hirame-tech/RCJ2023/img/Arduino-Leonardo_pinout.png

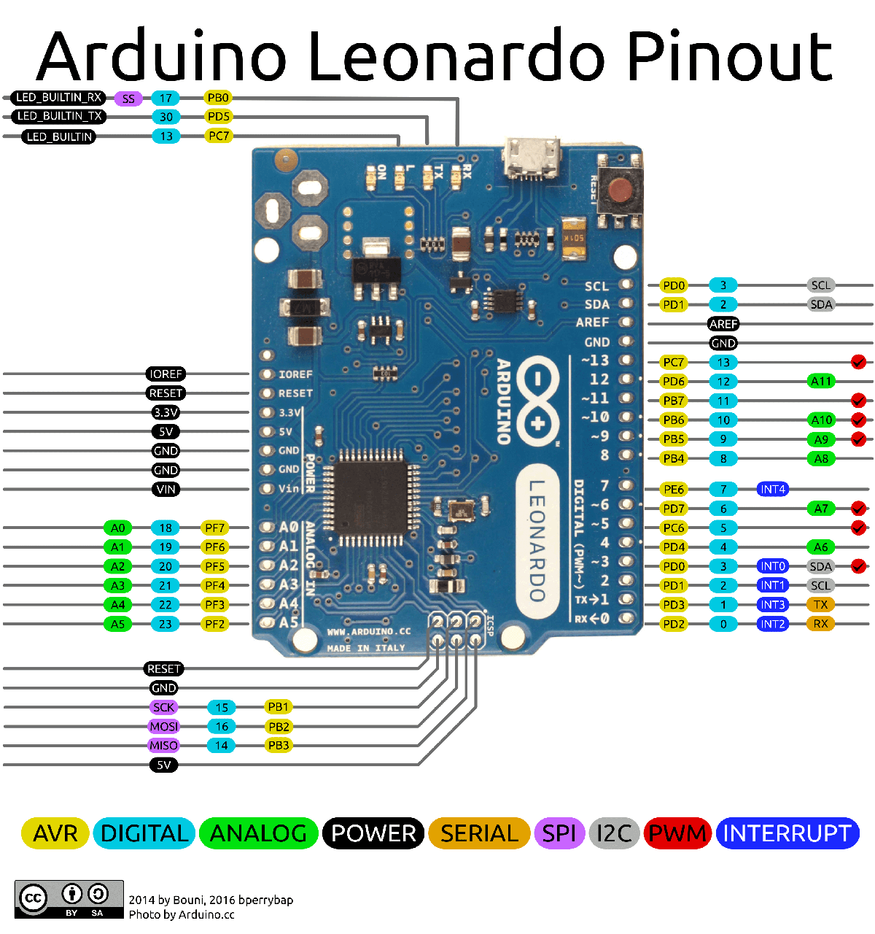
img/Arduino-Leonardo_pinout.png
