hirame-tech/RCJ2023/README.md

# README規則
- 基板のバージョンごとの変更点、issue等はboard内の各基板フォルダに書く
- その他仕様等はプログラムが保存されているフォルダ内の一番上の階層に配置されたREADMEに記述する。
