hirame-tech/RCJ2023/IRsensor/README.md

# pin assignment
|IR number|32U4 Pin|Digital Pin|
| :---: | :---: | :---: |
|0|19|2|
|1|25|4|
|2|26|12|
|3|27|6|
|4|28|8|
|5|29|9|
|6|1|7|
|7|41|23(A5)|
|8|40|22(A4)|
|9|39|21(A3)|
|10|38|20(A2)|
|11|37|19(A1)|
|12|36|18(A0)|
|13|32|13|
|14|31|5|
|15|30|10|
