hirame-tech/RCJ2023/main/README.md

Information of mainborad structure

## Teensy4.0
- Serial0 USB
- Serial1 IRsensor
- Serial2 Jyrosensor
- Serial3 Camera
- Serial4 motor0
- Serial5 motor1
- Serial6 motor2
- Serial7 motor3
