hirame-tech/RCJ2023/motor_driver_for_VNH/README.md

## 通信プロトコル
|data|解釈|
|----|----|
|0~100|motorA -255~255|
|128~228|motorB -255~255|
