hirame-tech/RCJ2023/board/power_supply/README.md

## power supply board v1
- OKLを手はんだに対応させた方がいいのでは？
- ヒューズの長さが違う
