hirame-tech/RCJ2023/motor_driver/README.md

# Serial通信内容
|data|解釈|
|----|----|
|0|ロック(未実装)|
|1~26|未定義|
|27~126|逆転 100 ~ 1|
|127|free stop|
|128~227|正転1~100|
|228~255|未定義|
