hirame-tech/RCJ2023/board/IRsensor/README.md

## v1_issure
- ~左のIRが上に1mmずれてる~ v1内で修正済み
- SPI引き出し忘れ
