hirame-tech/RCJ2023/board/mainboard/README.md

#v1 isuue
 - RCフィルタのコンデンサがin側についている(out側にないといけない)
