hirame-tech/RCJ2023/img/motor_direction.png

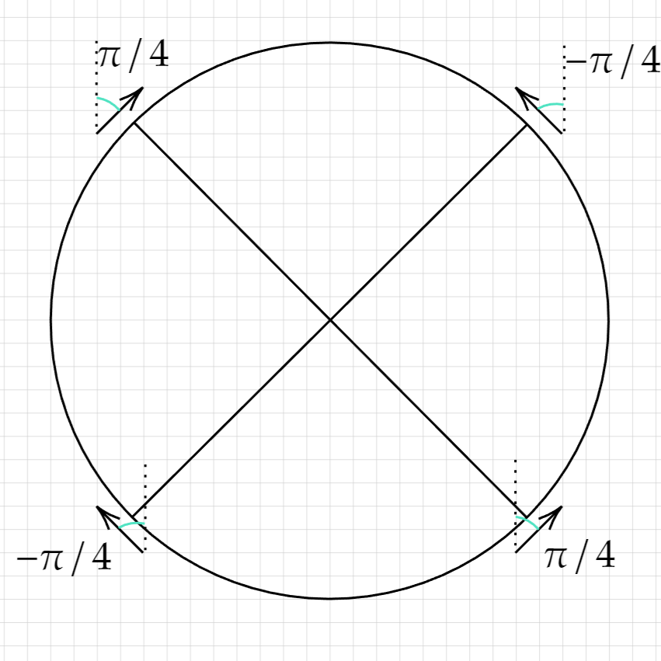
img/motor_direction.png
