hirame-tech/RCJ2023/board/BLDCdriver_test/encorder/parts_value.PNG

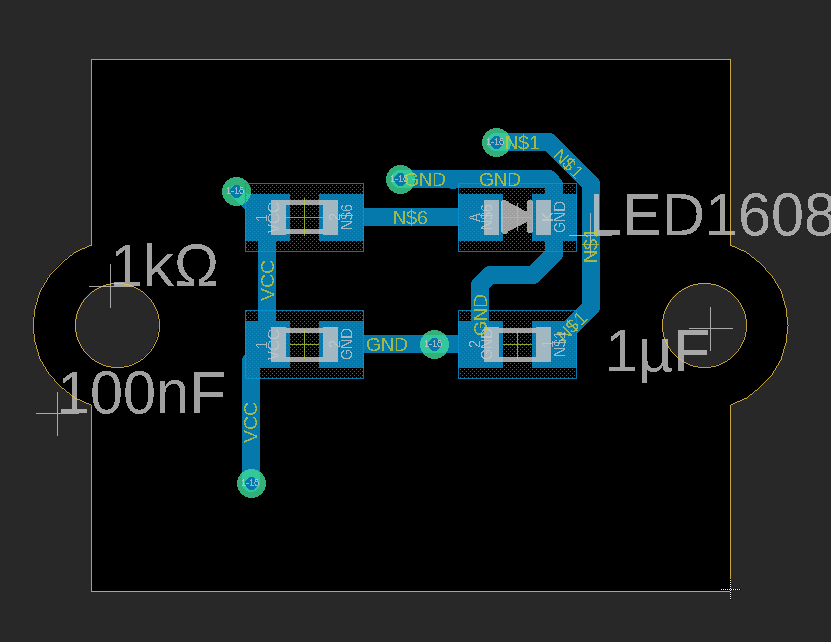
board/BLDCdriver_test/encorder/parts_value.PNG
