hirame-tech/RCJ2023/board/BLDCdriver_test/BLDCdriver v1.1/dimention_driver.dxf

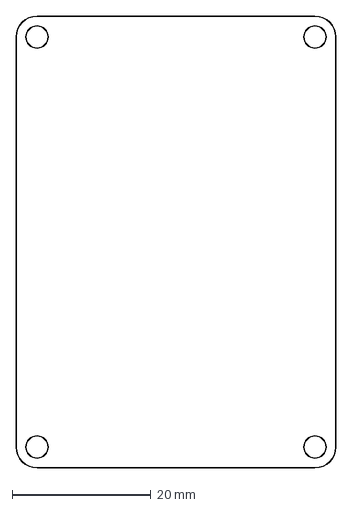
[picture p4: CAD file, 2022-12-12]
board/BLDCdriver_test/BLDCdriver v1.1/dimention_driver.dxf
46.0 x 65.0 mm
