hirame-tech/RCJ2023/board/BLDCdriver_test/encorder/Dimentions.dxf

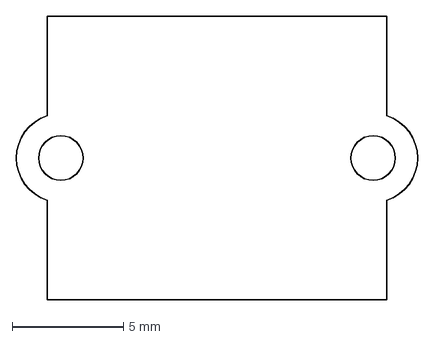
[picture p5: CAD file, 2022-12-12]
board/BLDCdriver_test/encorder/Dimentions.dxf
18.0 x 12.7 mm
