hirame-tech/RCJ2023/board/gyrosensor/dimention.dxf

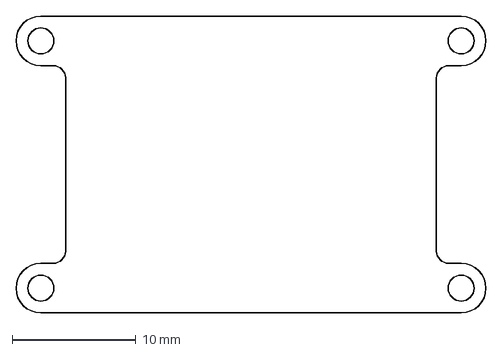
[picture p6: CAD file, 2022-12-12]
board/gyrosensor/dimention.dxf
38.0 x 24.0 mm
