hirame-tech/RCJ2023/board/IRsensor/dimension.dxf

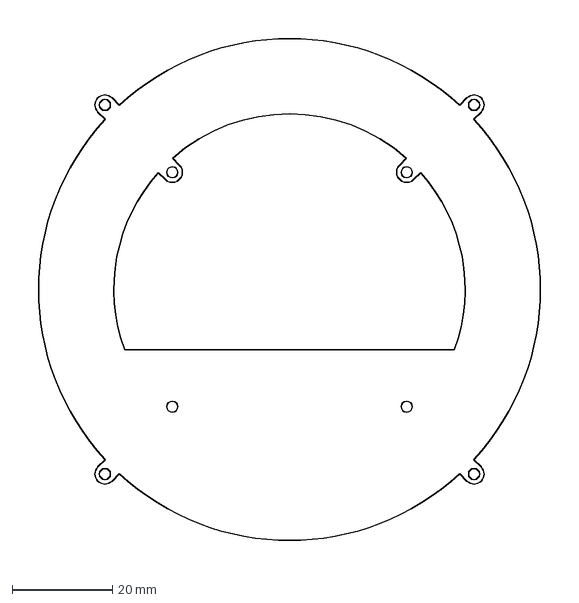
[picture p7: CAD file, 2022-12-12]
board/IRsensor/dimension.dxf
108.8 x 108.8 mm
