hirame-tech/RCJ2023/board/line_sensor_test/dimention.dxf

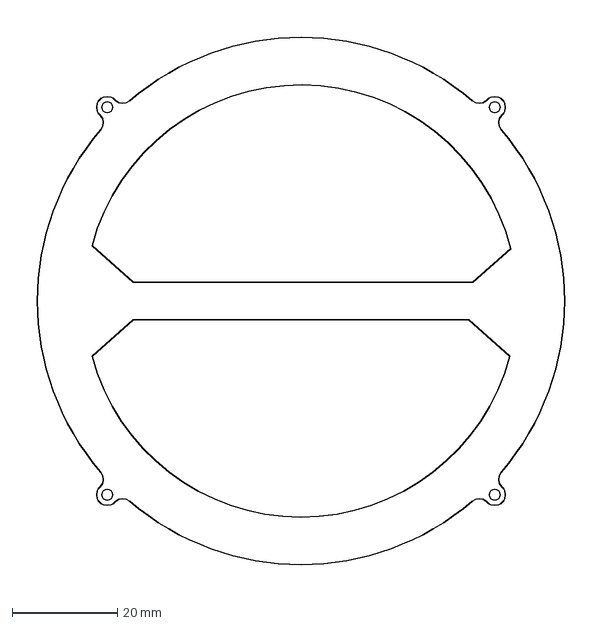
[picture p8: CAD file, 2022-12-12]
board/line_sensor_test/dimention.dxf
108.0 x 108.0 mm
