hirame-tech/RCJ2023/board/mainboard/dimention.dxf

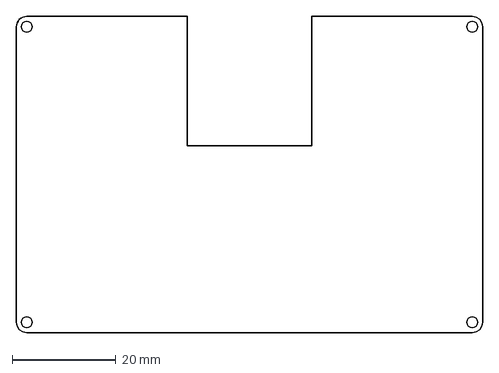
[picture p9: CAD file, 2022-12-12]
board/mainboard/dimention.dxf
90.0 x 61.0 mm
