hirame-tech/RCJ2023/board/power_supply/dimention.dxf

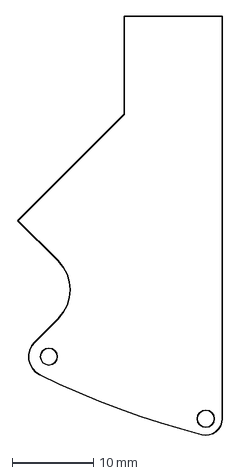
[picture p10: CAD file, 2022-12-12]
board/power_supply/dimention.dxf
25.1 x 51.5 mm
