hirame-tech/RCJ2023/board/power_supply/v2/diem.dxf

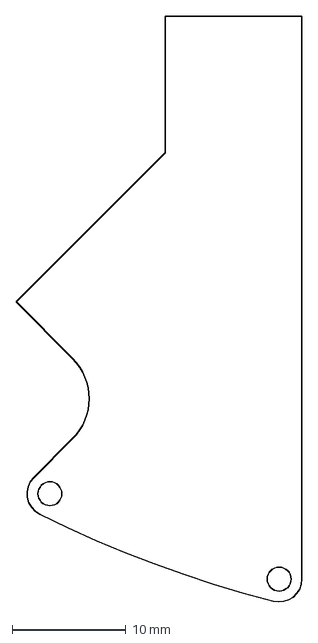
[picture p11: CAD file, 2022-12-12]
board/power_supply/v2/diem.dxf
25.1 x 51.5 mm
