hirame-tech/RCJ2023/board/UI_board/v1/dimention.dxf

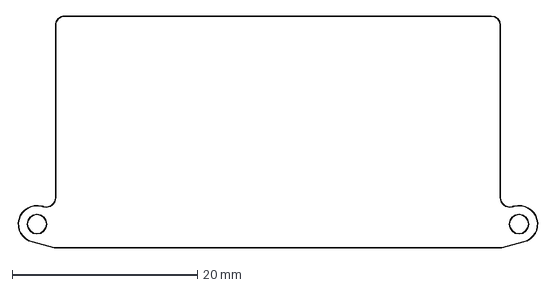
[picture p12: CAD file, 2022-12-12]
board/UI_board/v1/dimention.dxf
56.4 x 25.0 mm
