hirame-tech/RCJ2023/software_test/line_sensor/README.md

ラインセンサのArduinoUnoによる開発用のプロジェクトです。

2022-12-08現在、teensyに搭載したのでその状態から変更なし。今後の変更はmainの方で行う。
