hirame-tech/RCJ2023/board/BLDCdriver_test/README.md

## issue v1.0
- 1.SPIのSSの未配線
→~~CSをMD基板側でGNDに落として解決(v1.1)~~→SSをD6に配線
- 2.電源コネクタの配線が逆 → 元に戻した(v1.1)
