hirame-tech/RCJ2023/software_test/SerialReader/README.md

## SerialReaderの概要

30個のセンサ値をArduinoのシリアル出力から受け取り、256段階のグレースケールで表現します。
`rgb(0,0,0)`から`rgb(0,0,256)`

## 入力
0,1,2,3,4,5,6,...,30のようにカンマ区切りで30個のデータを読み込みます。

## 操作
`-select-`から任意のCOMを選択します。

なお、USBポートを抜き差ししたときには`Re-Scan`ボタンでCOMポートを再スキャンします。

`open`ボタンを押すとCOMのシリアルを開き、動作を開始します。

`close`ボタンでシリアルを閉じます。

`clear`ボタンで現在の読み込んだセンサ値を一度リセットします。

## バージョン情報

2022-11-19 ver0.0.1公開
- Splitコマンドでも分割ができなかった問題を修正。
- グレースケールでの表示に切り替え。
- GitHub上に初公開。
