hirame-tech/RCJ2023/board/BLDCdriver_test/BLDCdriver v1.0/untitled.brd

## EAGLE design board/BLDCdriver_test/BLDCdriver v1.0/untitled.brd (2022-12-12, an earlier design)

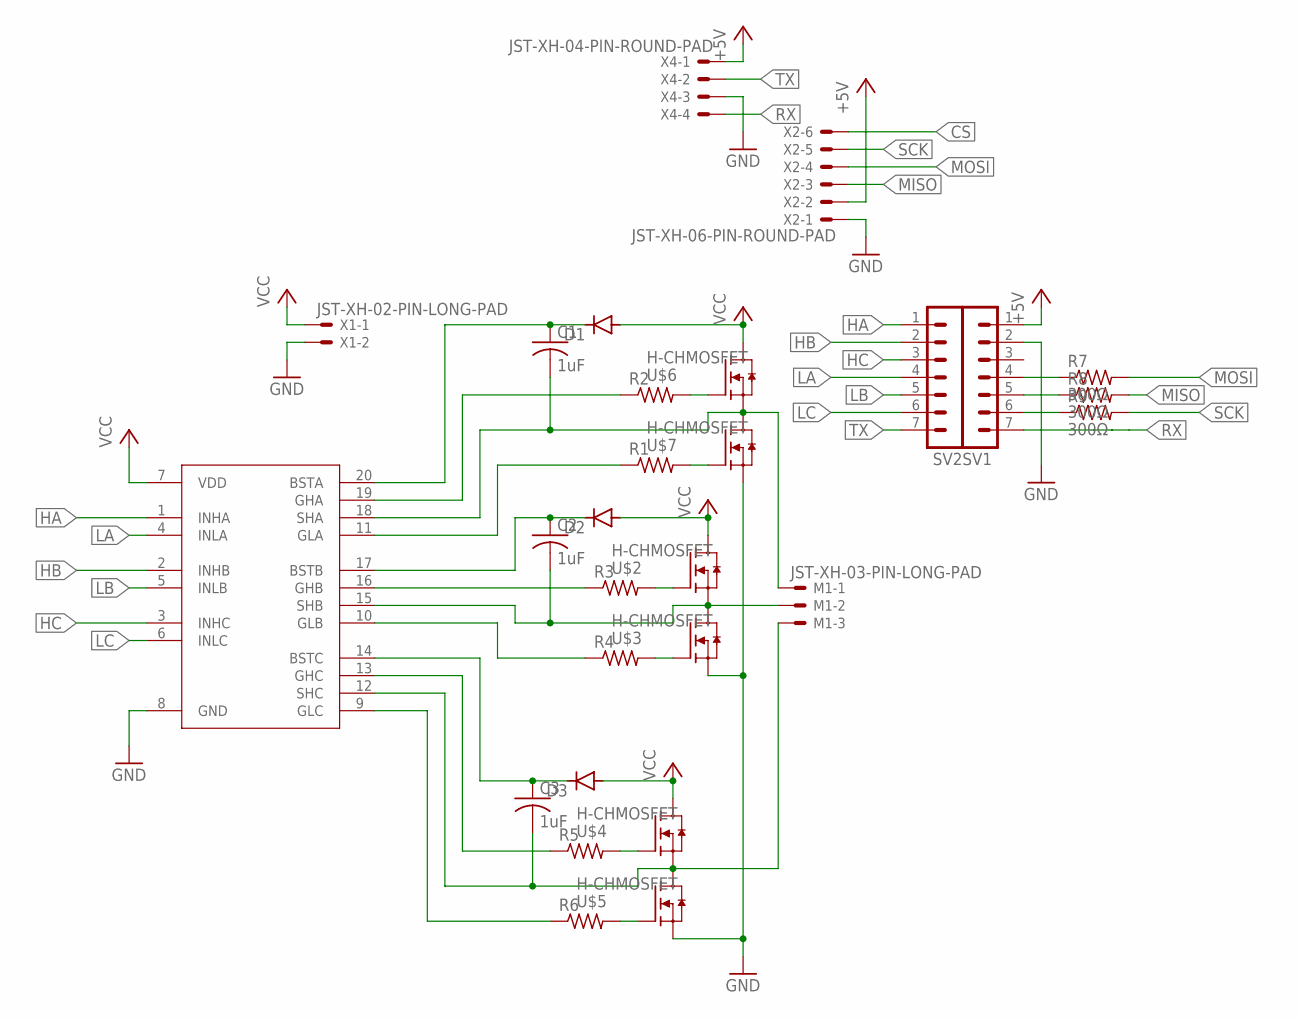
[picture p13: schematic untitled.sch]

Parts:
C1, C2, C3: 1uF; C2012
D1, D2, D3: DIODE-DO-214AC; DO-214AC
M1: JST-XH-03-PIN-LONG-PAD; JST-XH-03-PACKAGE-LONG-PAD
R1, R2, R3, R4, R5, R6: R-US_M2012; M2012
R7, R8, R9: 300Ω; M2012
SV1, SV2: MA07-1
U$1: DRV8300NIPWR; SOIC65P640X120-20N
U$2, U$3, U$4, U$5, U$6, U$7: H-CHMOSFET; DPAK228P990X238-4N
X1: JST-XH-02-PIN-LONG-PAD; JST-XH-02-PACKAGE-LONG-PAD
X2: JST-XH-06-PIN-ROUND-PAD; JST-XH-06-PACKAGE-ROUND-PAD
X4: JST-XH-04-PIN-ROUND-PAD; JST-XH-04-PACKAGE-ROUND-PAD

Connections:
+5V: SV1.1, X2.2, X4.1
CS: X2.6
GND: SV1.2, U$1.8 (GND), U$3.3 (S), U$5.3 (S), U$7.3 (S), X1.2, X2.1, X4.3
HA: SV2.1, U$1.1 (INHA)
HB: SV2.2, U$1.2 (INHB)
HC: SV2.3, U$1.3 (INHC)
LA: SV2.4, U$1.4 (INLA)
LB: SV2.5, U$1.5 (INLB)
LC: SV2.6, U$1.6 (INLC)
MISO: R8.2, X2.3
MOSI: R7.2, X2.4
unnamed: C2.2, M1.2, U$1.15 (SHB), U$2.3 (S), U$3.4 (D)
unnamed: C3.2, M1.3, U$1.12 (SHC), U$4.3 (S), U$5.4 (D)
unnamed: C1.2, M1.1, U$1.18 (SHA), U$6.3 (S), U$7.4 (D)
unnamed: R2.2, U$6.1 (G)
unnamed: R1.2, U$7.1 (G)
unnamed: R2.1, U$1.19 (GHA)
unnamed: R1.1, U$1.11 (GLA)
unnamed: R3.2, U$2.1 (G)
unnamed: C1.1, D1.C, U$1.20 (BSTA)
unnamed: R4.2, U$3.1 (G)
unnamed: R7.1, SV1.4
unnamed: R3.1, U$1.16 (GHB)
unnamed: C2.1, D2.C, U$1.17 (BSTB)
unnamed: R4.1, U$1.10 (GLB)
unnamed: R6.2, U$5.1 (G)
unnamed: R5.2, U$4.1 (G)
unnamed: R5.1, U$1.13 (GHC)
unnamed: R6.1, U$1.9 (GLC)
unnamed: C3.1, D3.C, U$1.14 (BSTC)
unnamed: R9.1, SV1.6
unnamed: R8.1, SV1.5
RX: SV1.7, X4.4
SCK: R9.2, X2.5
TX: SV2.7, X4.2
VCC: D1.A, D2.A, D3.A, U$1.7 (VDD), U$2.4 (D), U$4.4 (D), U$6.4 (D), X1.1

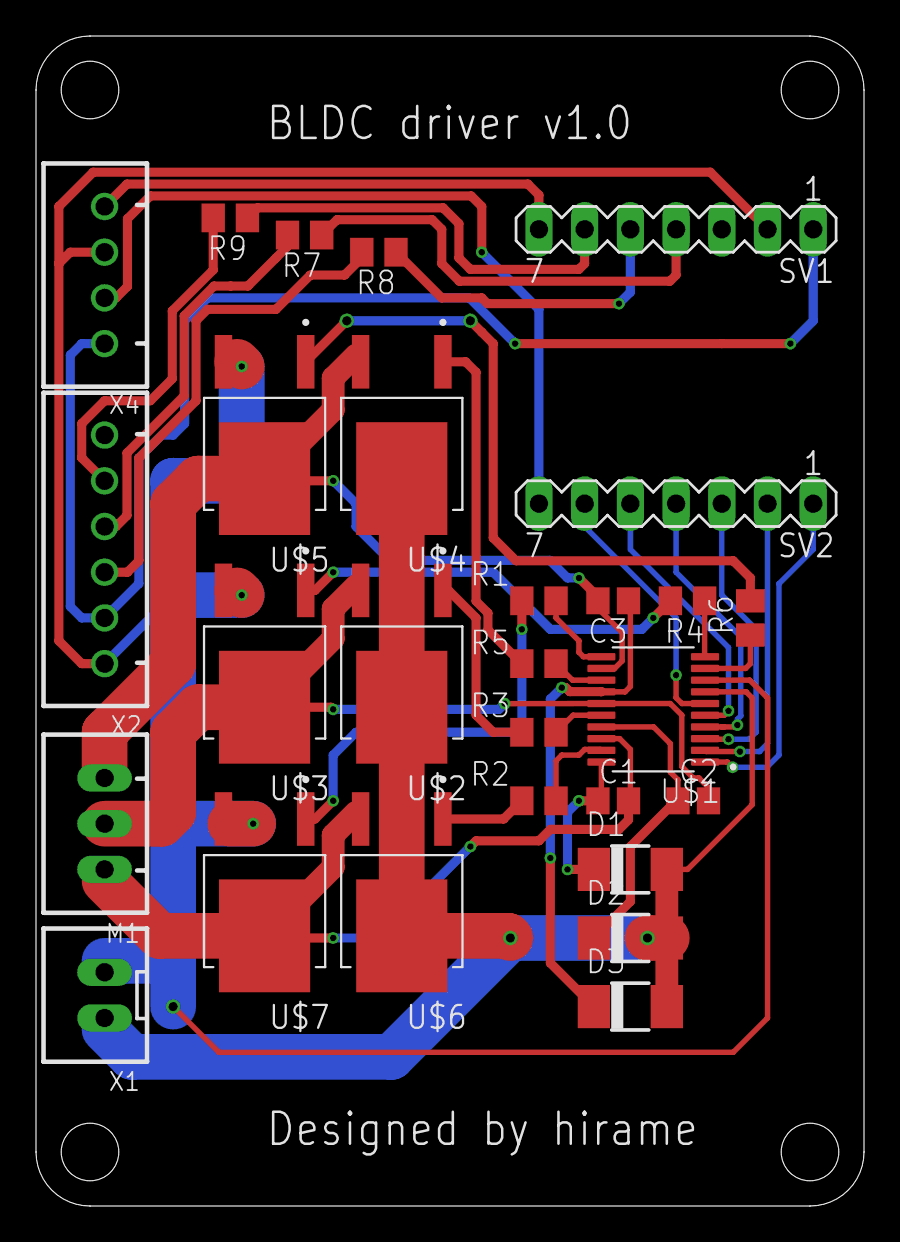
[picture p14: board board/BLDCdriver_test/BLDCdriver v1.0/untitled.brd from above]

Board: 2 copper layers, 46.0 x 65.0 mm, 28 parts (0 on the bottom side), 35 nets.
