hirame-tech/RCJ2023/board/usb_hub_board/untitled.brd

## EAGLE design board/usb_hub_board/untitled.brd (2022-12-12)

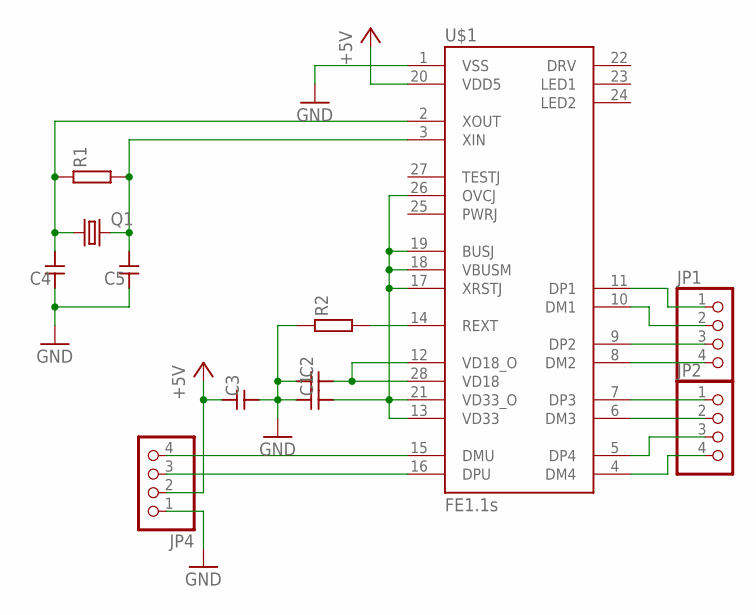
[picture p15: schematic untitled.sch]

Parts:
C1, C2, C3, C4, C5: CAPACITOR1608; SMD1608
JP1, JP2, JP4: PINHD-1X4; 1X04
Q1: CRYSTALHC49S; HC49/S
R1, R2: RESISTOR1608; SMD1608
U$1: FE1.1S; FE1.1S_SSOP-28

Connections:
+5V: C3.1, JP4.2, U$1.20 (VDD5)
GND: C1.1, C2.1, C3.2, C4.1, C5.1, JP4.1, R2.1, U$1.1 (VSS)
unnamed: JP4.4, U$1.15 (DMU)
unnamed: R2.2, U$1.14 (REXT)
unnamed: C2.2, U$1.12 (VD18_O), U$1.28 (VD18)
unnamed: C4.2, Q1.1, R1.1, U$1.2 (XOUT)
unnamed: C1.2, U$1.13 (VD33), U$1.17 (XRSTJ), U$1.18 (VBUSM), U$1.19 (BUSJ), U$1.21 (VD33_O), U$1.26 (OVCJ)
unnamed: C5.2, Q1.2, R1.2, U$1.3 (XIN)
unnamed: JP4.3, U$1.16 (DPU)
unnamed: JP1.4, U$1.8 (DM2)
unnamed: JP2.1, U$1.7 (DP3)
unnamed: JP2.2, U$1.6 (DM3)
unnamed: JP2.3, U$1.5 (DP4)
unnamed: JP2.4, U$1.4 (DM4)
unnamed: JP1.3, U$1.9 (DP2)
unnamed: JP1.2, U$1.10 (DM1)
unnamed: JP1.1, U$1.11 (DP1)

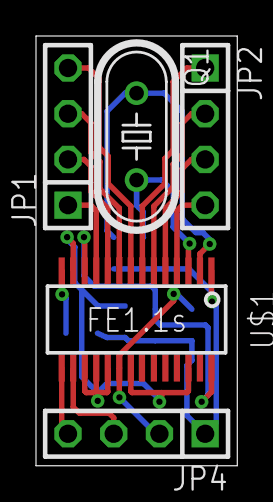
[picture p16: board board/usb_hub_board/untitled.brd from above]

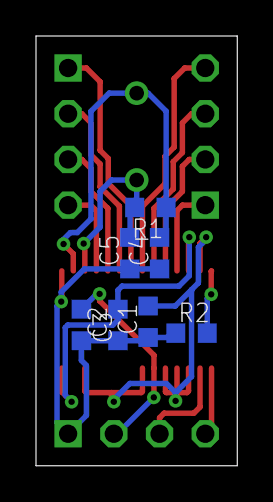
[picture p17: board board/usb_hub_board/untitled.brd from below]

Board: 2 copper layers, 11.2 x 23.9 mm, 12 parts (7 on the bottom side), 17 nets.
