hirame-tech/RCJ2023/board/catch_sensor/untitled.brd

## EAGLE design board/catch_sensor/untitled.brd (2022-12-12)

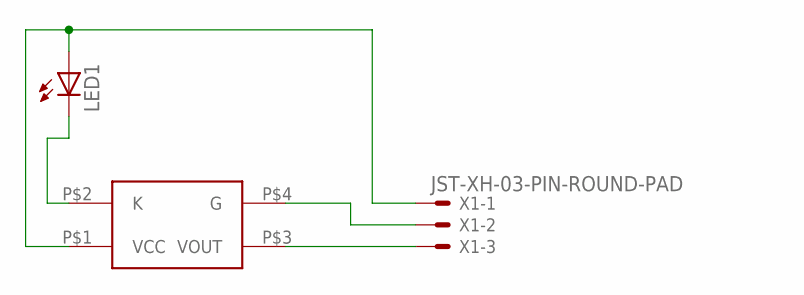
[picture p18: schematic untitled.sch]

Parts:
LED1: LED3MM
U$1: S4282-51
X1: JST-XH-03-PIN-ROUND-PAD; JST-XH-03-PACKAGE-ROUND-PAD

Connections:
unnamed: LED1.K (C), U$1.P$2 (K)
unnamed: U$1.P$3 (VOUT), X1.3
unnamed: LED1.A, U$1.P$1 (VCC), X1.1
unnamed: U$1.P$4 (G), X1.2

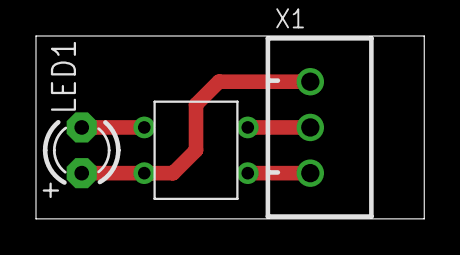
[picture p19: board board/catch_sensor/untitled.brd from above]

Board: 2 copper layers, 21.6 x 10.2 mm, 3 parts (0 on the bottom side), 4 nets.
