hirame-tech/RCJ2023/board/gyrosensor/untitled.brd

## EAGLE design board/gyrosensor/untitled.brd (2022-12-12)

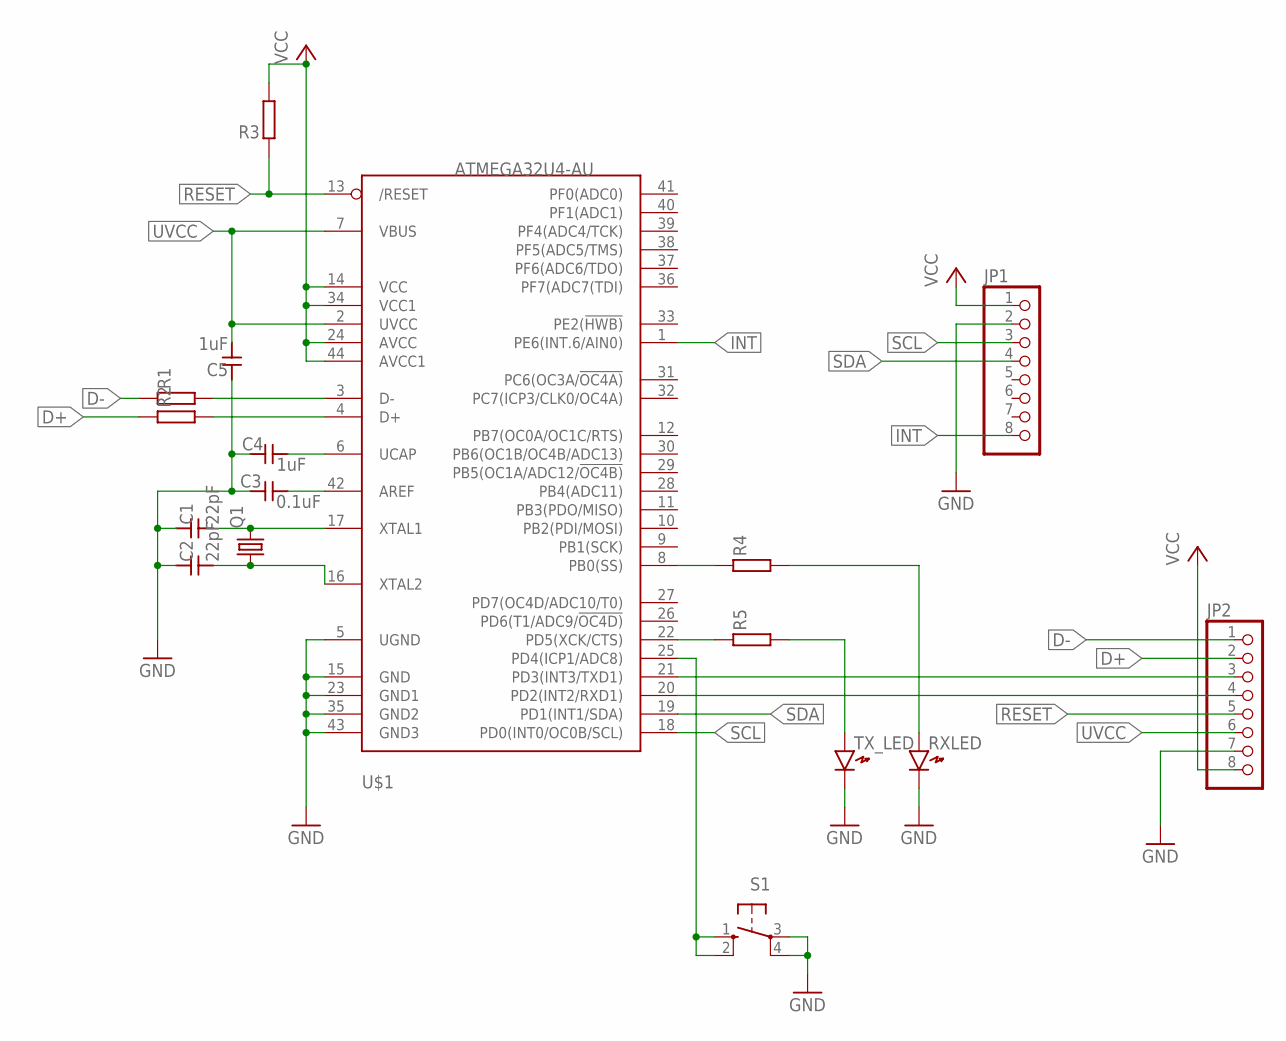
[picture p20: schematic untitled.sch]

Parts:
C1, C2: 22pF; SMD1608
C3: 0.1uF; SMD1608
C4, C5: 1uF; SMD1608
JP1, JP2: PINHD-1X8; 1X08
Q1: CRYSTALHC49S; HC49/S
R1, R2, R3, R4, R5: RESISTOR1608; SMD1608
RXLED: LED1608
S1: 10-XX; B3F-10XX
TX_LED: LED1608
U$1: ATMEGA32U4-AU; TQFP44

Connections:
D+: JP2.2, R2.1
D-: JP2.1, R1.1
GND: C1.1, C2.1, C3.1, C4.1, C5.1, JP1.2, JP2.7, RXLED.K, S1.3, S1.4 (P1), TX_LED.K, U$1.5 (UGND), U$1.15 (GND), U$1.23 (GND1), U$1.35 (GND2), U$1.43 (GND3)
INT: JP1.8, U$1.1 (PE6(INT.6/AIN0))
unnamed: C1.2, Q1.2, U$1.17 (XTAL1)
unnamed: C2.2, Q1.1, U$1.16 (XTAL2)
unnamed: C4.2, U$1.6 (UCAP)
unnamed: C3.2, U$1.42 (AREF)
unnamed: S1.1 (S), S1.2 (S1), U$1.25 (PD4(ICP1/ADC8))
unnamed: R4.1, U$1.8 (PB0(SS))
unnamed: R5.1, U$1.22 (PD5(XCK/CTS))
unnamed: R1.2, U$1.3 (D-)
unnamed: R2.2, U$1.4 (D+)
unnamed: R5.2, TX_LED.A
unnamed: R4.2, RXLED.A
unnamed: JP2.3, U$1.21 (PD3(INT3/TXD1))
unnamed: JP2.4, U$1.20 (PD2(INT2/RXD1))
RESET: JP2.5, R3.1, U$1.13 (/RESET)
SCL: JP1.3, U$1.18 (PD0(INT0/OC0B/SCL))
SDA: JP1.4, U$1.19 (PD1(INT1/SDA))
UVCC: C5.2, JP2.6, U$1.2 (UVCC), U$1.7 (VBUS)
VCC: JP1.1, JP2.8, R3.2, U$1.14 (VCC), U$1.24 (AVCC), U$1.34 (VCC1), U$1.44 (AVCC1)

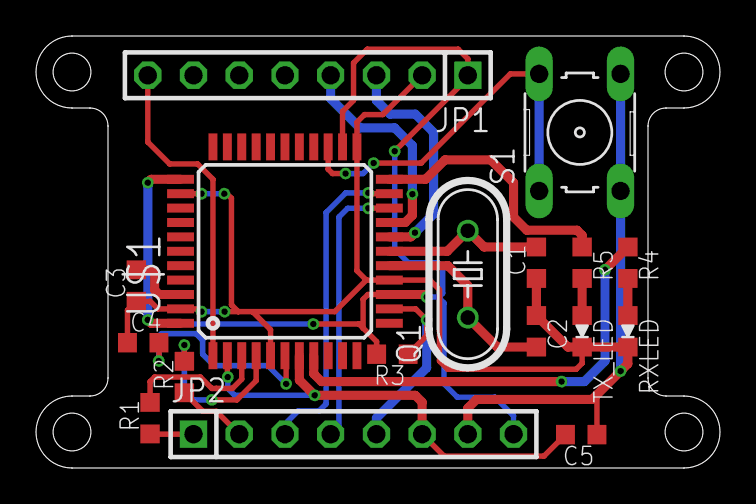
[picture p21: board board/gyrosensor/untitled.brd from above]

Board: 2 copper layers, 38.0 x 24.0 mm, 17 parts (0 on the bottom side), 22 nets.
