hirame-tech/RCJ2023/board/power_supply/v2/5v_unit.brd

## EAGLE design board/power_supply/v2/5v_unit.brd (2022-12-12)

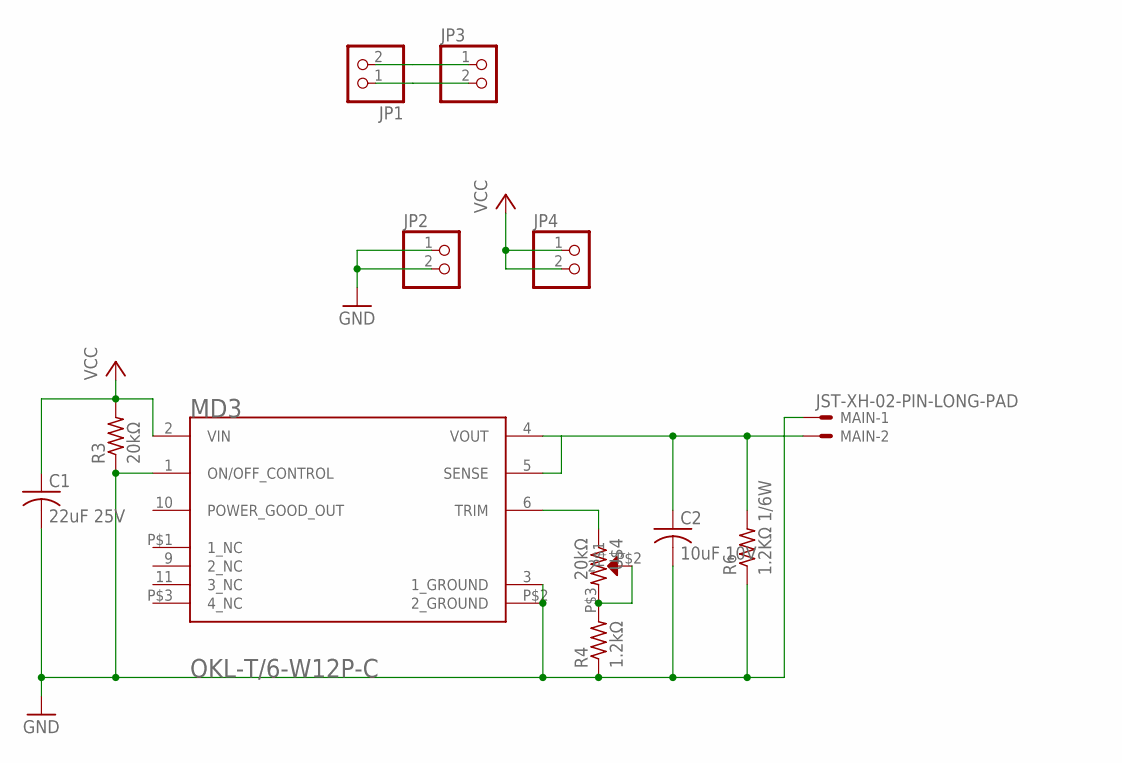
[picture p22: schematic 5v_unit.sch]

Parts:
C1: 22uF 25V; C2012
C2: 10uF 10V; C2012
JP1, JP2, JP3, JP4: PINHD-1X2; 1X02
MAIN: JST-XH-02-PIN-LONG-PAD; JST-XH-02-PACKAGE-LONG-PAD
MD3: OKL-T/6-W12P-CMURATA_OKL-T-6-W12P-C_0_0; MURATA_OKL-T-6-W12P-C_0
R3: 20kΩ; M2012
R4: 1.2kΩ; M2012
R6: 1.2KΩ 1/6W; 0805-THM
U$4: 20kΩ; R-TRIM

Connections:
GND: C1.2, C2.2, JP2.1, JP2.2, MAIN.1, MD3.1 (ON/OFF_CONTROL), MD3.3 (1_GROUND), MD3.P$2 (2_GROUND), R3.1, R4.1, R6.1
unnamed: JP1.1, JP1.2, JP3.1, JP3.2
unnamed: R4.2, U$4.P$2 (2), U$4.P$3
unnamed: C2.1, MAIN.2, MD3.4 (VOUT), MD3.5 (SENSE), R6.2
unnamed: MD3.6 (TRIM), U$4.P$1 (1)
VCC: C1.1, JP4.1, JP4.2, MD3.2 (VIN), R3.2

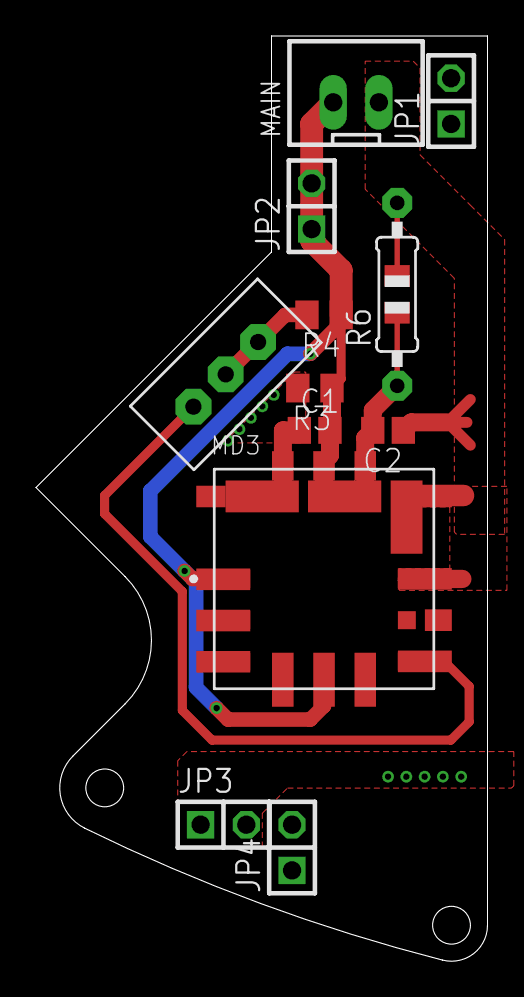
[picture p23: board 5v_unit.brd from above]

Board: 2 copper layers, 25.1 x 51.4 mm, 12 parts (0 on the bottom side), 6 nets.
