hirame-tech/RCJ2023/board/UI_board/v1/untitled.brd

## EAGLE design board/UI_board/v1/untitled.brd (2022-12-12)

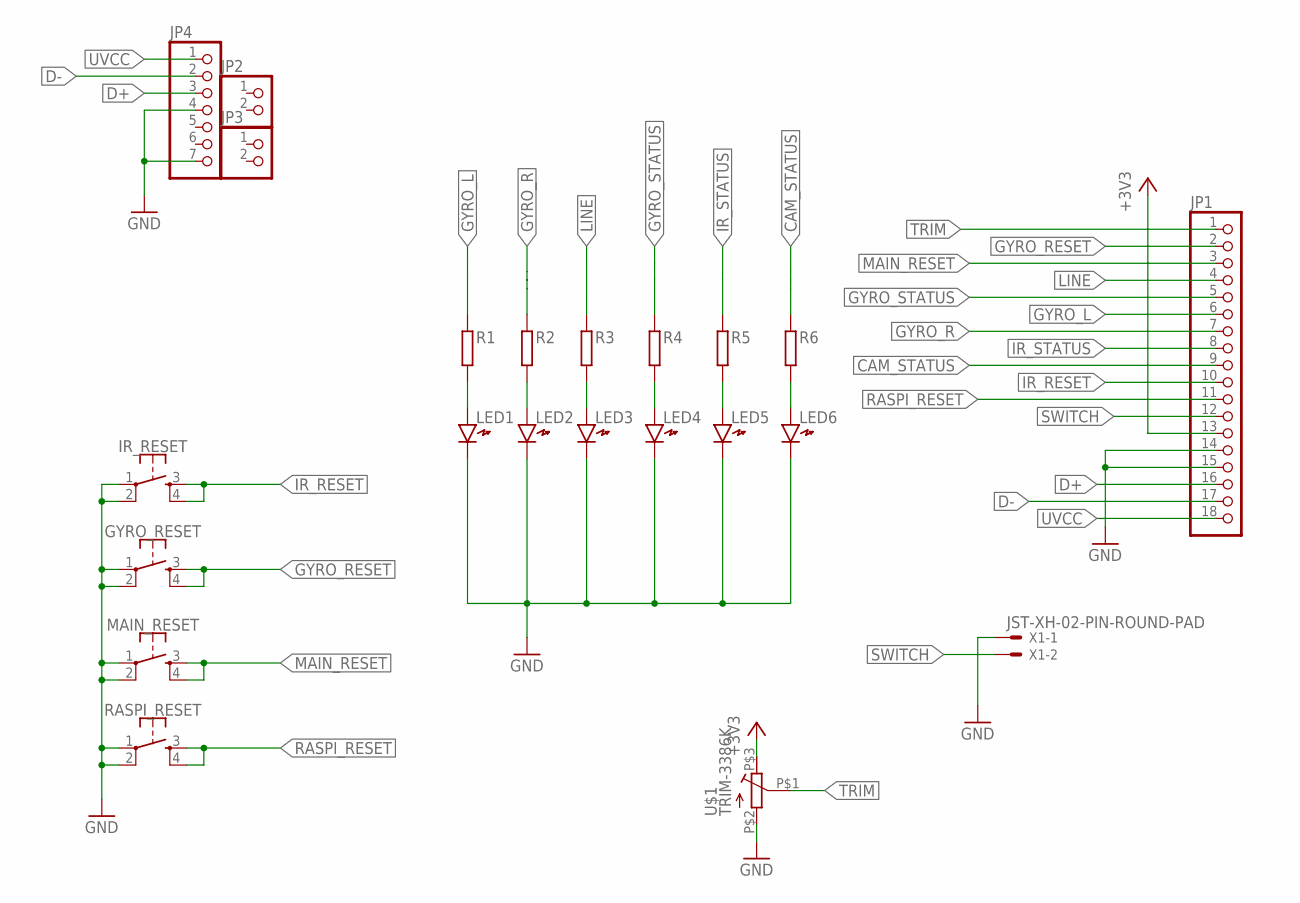
[picture p24: schematic untitled.sch]

Parts:
GYRO_RESET: MOMENTARY-SWITCH-SPST-2-SMD-5.2MM; TACTILE_SWITCH_SMD_5.2MM
IR_RESET: MOMENTARY-SWITCH-SPST-2-SMD-5.2MM; TACTILE_SWITCH_SMD_5.2MM
JP1: PINHD-1X18; 1X18
JP2, JP3: PINHD-1X2; 1X02
JP4: PINHD-1X7; 1X07
LED1, LED2, LED3, LED4, LED5, LED6: LED1608
MAIN_RESET: MOMENTARY-SWITCH-SPST-2-SMD-5.2MM; TACTILE_SWITCH_SMD_5.2MM
R1, R2, R3, R4, R5, R6: RESISTOR1608; SMD1608
RASPI_RESET: MOMENTARY-SWITCH-SPST-2-SMD-5.2MM; TACTILE_SWITCH_SMD_5.2MM
U$1: TRIM-3386K
X1: JST-XH-02-PIN-ROUND-PAD; JST-XH-02-PACKAGE-ROUND-PAD

Connections:
+3V3: JP1.13, U$1.P$3 (1)
CAM_STATUS: JP1.9, R6.1
D+: JP1.16, JP4.3
D-: JP1.17, JP4.2
GND: GYRO_RESET.1, GYRO_RESET.2, IR_RESET.1, IR_RESET.2, JP1.14, JP1.15, JP4.4, JP4.7, LED1.K, LED2.K, LED3.K, LED4.K, LED5.K, LED6.K, MAIN_RESET.1, MAIN_RESET.2, RASPI_RESET.1, RASPI_RESET.2, U$1.P$2 (2), X1.1
GYRO_L: JP1.6, R1.1
GYRO_R: JP1.7, R2.1
GYRO_RESET: GYRO_RESET.3, GYRO_RESET.4, JP1.2
GYRO_STATUS: JP1.5, R4.1
IR_RESET: IR_RESET.3, IR_RESET.4, JP1.10
IR_STATUS: JP1.8, R5.1
LINE: JP1.4, R3.1
MAIN_RESET: JP1.3, MAIN_RESET.3, MAIN_RESET.4
unnamed: LED1.A, R1.2
unnamed: LED2.A, R2.2
unnamed: LED3.A, R3.2
unnamed: LED4.A, R4.2
unnamed: LED5.A, R5.2
unnamed: LED6.A, R6.2
RASPI_RESET: JP1.11, RASPI_RESET.3, RASPI_RESET.4
SWITCH: JP1.12, X1.2
TRIM: JP1.1, U$1.P$1 (3)
UVCC: JP1.18, JP4.1

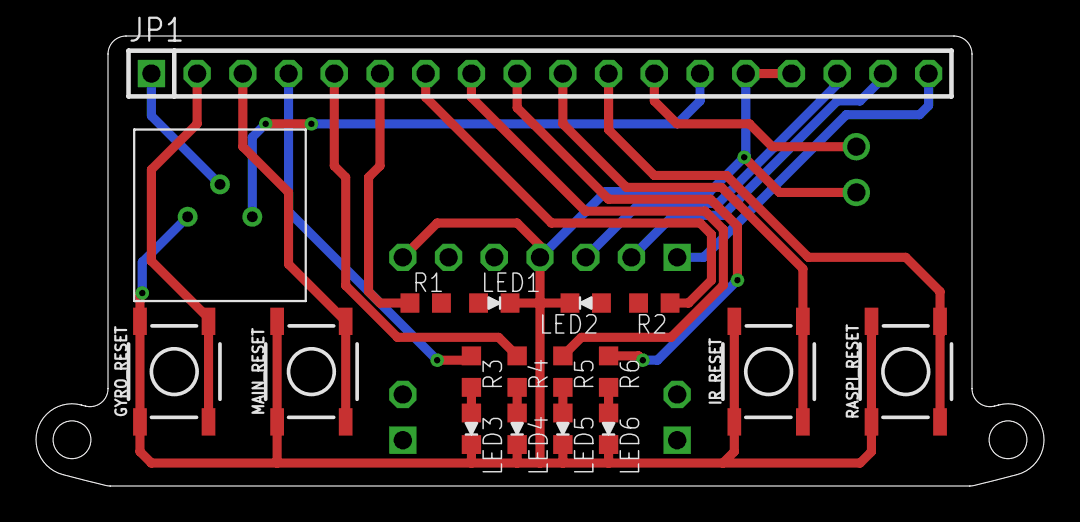
[picture p25: board board/UI_board/v1/untitled.brd from above]

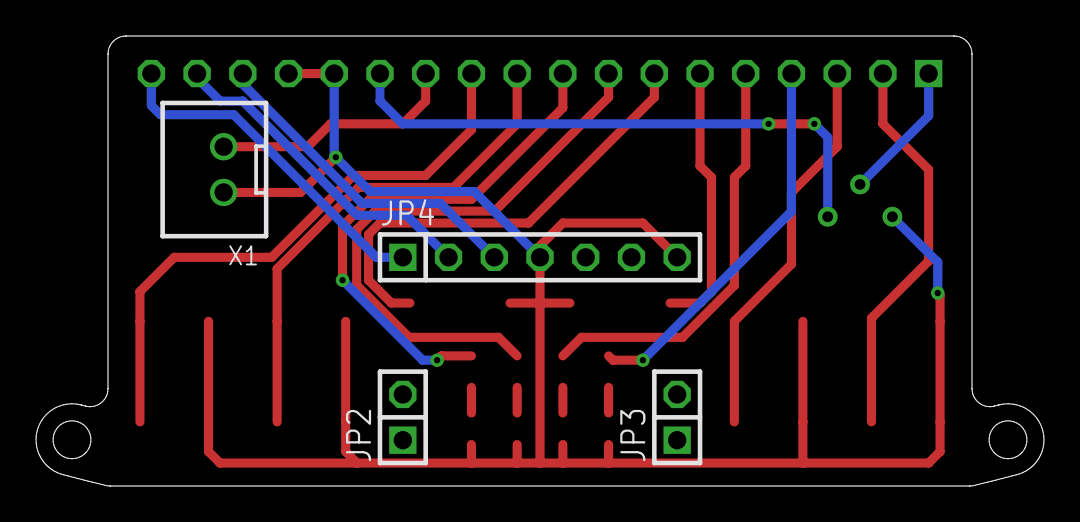
[picture p26: board board/UI_board/v1/untitled.brd from below]

Board: 2 copper layers, 56.0 x 25.0 mm, 22 parts (4 on the bottom side), 23 nets.
