hirame-tech/RCJ2023/board/mainboard/untitled.brd

## EAGLE design board/mainboard/untitled.brd (2022-12-12)

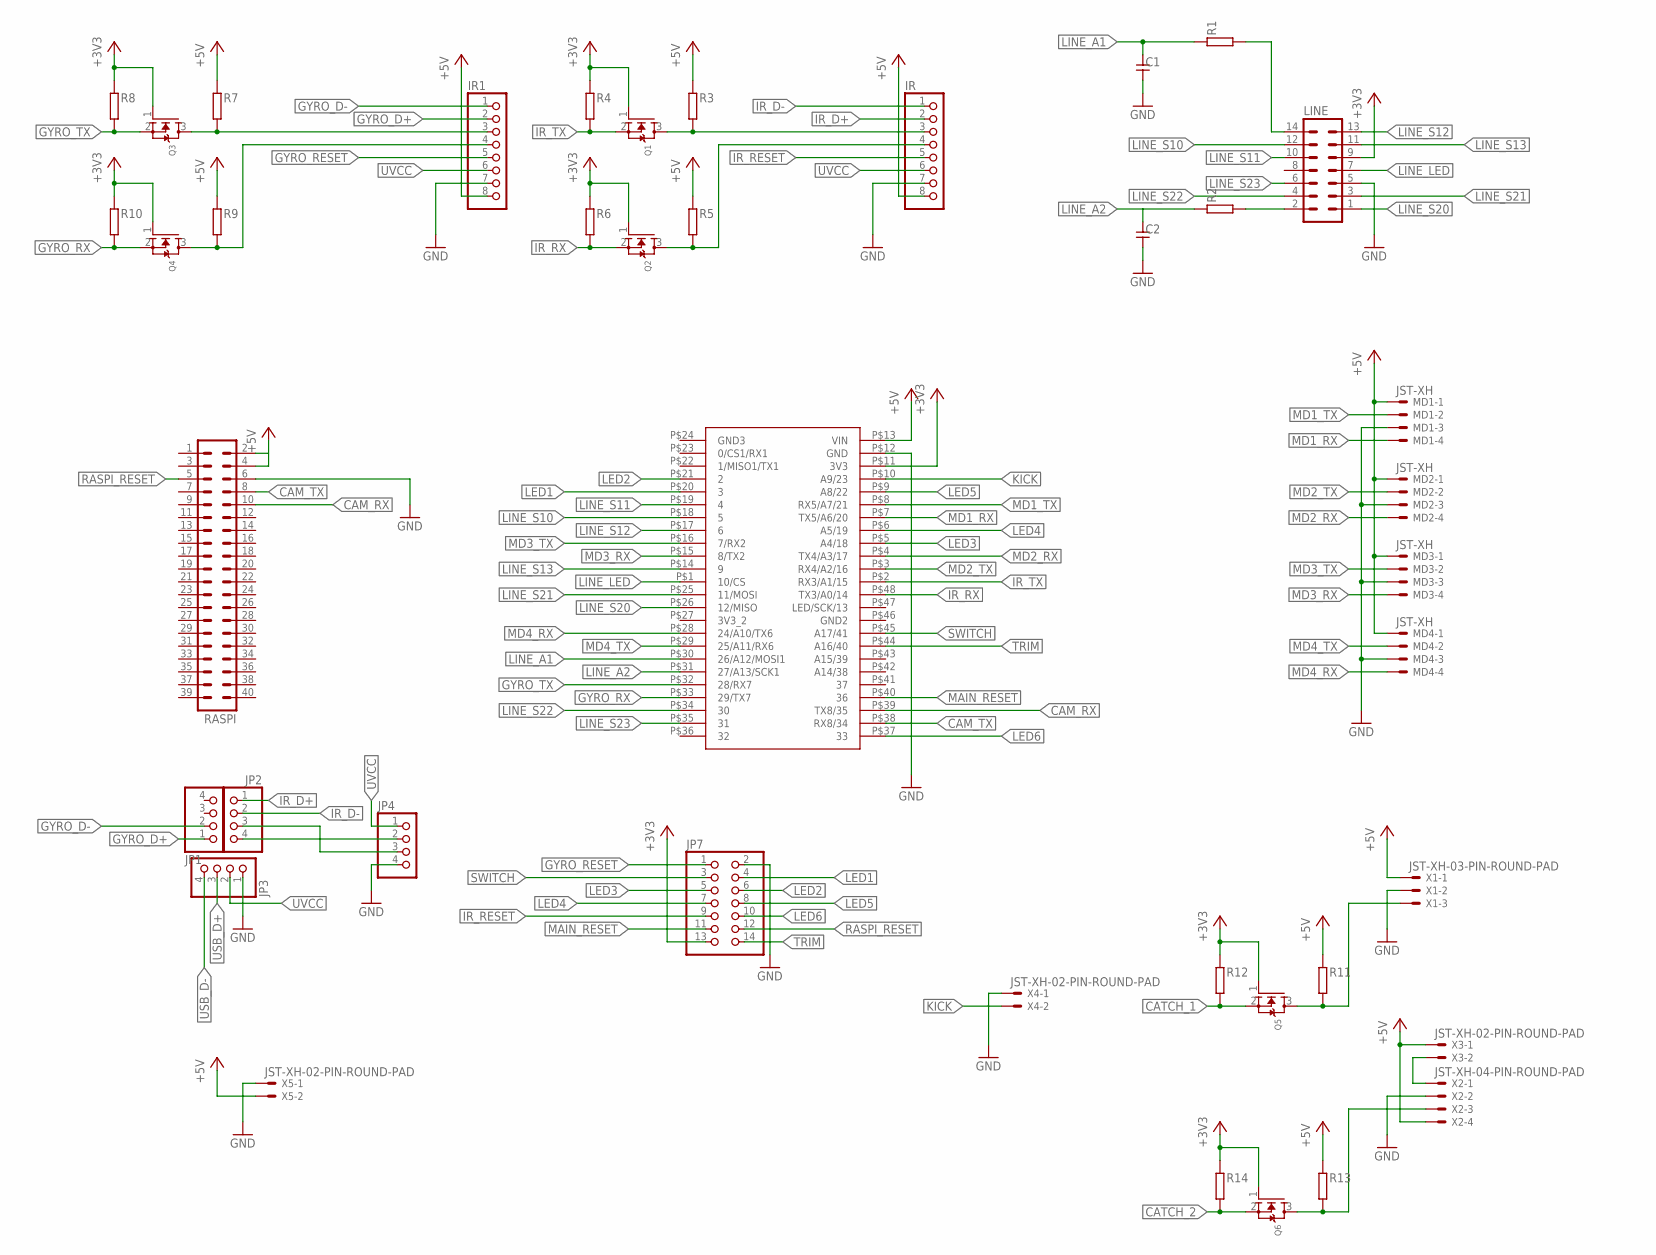
[picture p27: schematic untitled.sch]

Parts:
C1, C2: CAPACITOR1608; SMD1608
IR, IR1: PINHD-1X8; 1X08
JP1, JP2, JP3, JP4: PINHD-1X4; 1X04
JP7: PINHD-2X7; 2X07
LINE: MA07-2
MD1, MD2, MD3, MD4: JST-XH; JST-XH-04-PACKAGE-ROUND-PAD
Q1, Q2, Q3, Q4, Q5, Q6: MOSFET-NREFLOW; SOT23
R1, R2, R3, R4, R5, R6, R7, R8, R9, R10, R11, R12, R13, R14: RESISTOR1608; SMD1608
RASPI: MA20-2
U$1: TEENSY4.1
X1: JST-XH-03-PIN-ROUND-PAD; JST-XH-03-PACKAGE-ROUND-PAD
X2: JST-XH-04-PIN-ROUND-PAD; JST-XH-04-PACKAGE-ROUND-PAD
X3, X4, X5: JST-XH-02-PIN-ROUND-PAD; JST-XH-02-PACKAGE-ROUND-PAD

Connections:
+3V3: JP7.13, LINE.9, Q1.1 (G), Q2.1 (G), Q3.1 (G), Q4.1 (G), Q5.1 (G), Q6.1 (G), R4.1, R6.1, R8.1, R10.1, R12.1, R14.1, U$1.P$11 (3V3)
+5V: IR.8, IR1.8, MD1.1, MD2.1, MD3.1, MD4.1, R3.1, R5.1, R7.1, R9.1, R11.1, R13.1, RASPI.2, RASPI.4, U$1.P$13 (VIN), X1.1, X2.4, X3.1, X5.2
CAM_RX: RASPI.10, U$1.P$39 (TX8/35)
CAM_TX: RASPI.8, U$1.P$38 (RX8/34)
CATCH_1: Q5.2 (S), R12.2
CATCH_2: Q6.2 (S), R14.2
GND: C1.2, C2.2, IR.7, IR1.7, JP3.1, JP4.4, JP7.2, LINE.5, MD1.3, MD2.3, MD3.3, MD4.3, RASPI.6, U$1.P$12 (GND), X1.2, X2.2, X4.1, X5.1
GYRO_D+: IR1.2, JP1.1
GYRO_D-: IR1.1, JP1.2
GYRO_RESET: IR1.5, JP7.1
GYRO_RX: Q4.2 (S), R10.2, U$1.P$33 (29/TX7)
GYRO_TX: Q3.2 (S), R8.2, U$1.P$32 (28/RX7)
IR_D+: IR.2, JP2.1
IR_D-: IR.1, JP2.2
IR_RESET: IR.5, JP7.9
IR_RX: Q2.2 (S), R6.2, U$1.P$48 (TX3/A0/14)
IR_TX: Q1.2 (S), R4.2, U$1.P$2 (RX3/A1/15)
KICK: U$1.P$10 (A9/23), X4.2
LED1: JP7.4, U$1.P$20 (3)
LED2: JP7.6, U$1.P$21 (2)
LED3: JP7.5, U$1.P$5 (A4/18)
LED4: JP7.7, U$1.P$6 (A5/19)
LED5: JP7.8, U$1.P$9 (A8/22)
LED6: JP7.10, U$1.P$37 (33)
LINE_A1: C1.1, R1.1, U$1.P$30 (26/A12/MOSI1)
LINE_A2: C2.1, R2.1, U$1.P$31 (27/A13/SCK1)
LINE_LED: LINE.7, U$1.P$1 (10/CS)
LINE_S10: LINE.12, U$1.P$18 (5)
LINE_S11: LINE.10, U$1.P$19 (4)
LINE_S12: LINE.13, U$1.P$17 (6)
LINE_S13: LINE.11, U$1.P$14 (9)
LINE_S20: LINE.1, U$1.P$26 (12/MISO)
LINE_S21: LINE.3, U$1.P$25 (11/MOSI)
LINE_S22: LINE.4, U$1.P$34 (30)
LINE_S23: LINE.6, U$1.P$35 (31)
MAIN_RESET: JP7.11, U$1.P$40 (36)
MD1_RX: MD1.4, U$1.P$7 (TX5/A6/20)
MD1_TX: MD1.2, U$1.P$8 (RX5/A7/21)
MD2_RX: MD2.4, U$1.P$4 (TX4/A3/17)
MD2_TX: MD2.2, U$1.P$3 (RX4/A2/16)
MD3_RX: MD3.4, U$1.P$15 (8/TX2)
MD3_TX: MD3.2, U$1.P$16 (7/RX2)
MD4_RX: MD4.4, U$1.P$28 (24/A10/TX6)
MD4_TX: MD4.2, U$1.P$29 (25/A11/RX6)
unnamed: IR1.3, Q3.3 (D), R7.2
unnamed: LINE.14, R1.2
unnamed: LINE.2, R2.2
unnamed: IR.3, Q1.3 (D), R3.2
unnamed: IR1.4, Q4.3 (D), R9.2
unnamed: IR.4, Q2.3 (D), R5.2
unnamed: Q6.3 (D), R13.2, X2.3
unnamed: X2.1, X3.2
unnamed: Q5.3 (D), R11.2, X1.3
unnamed: JP2.4, JP4.2
unnamed: JP2.3, JP4.3
RASPI_RESET: JP7.12, RASPI.5
SWITCH: JP7.3, U$1.P$45 (A17/41)
TRIM: JP7.14, U$1.P$44 (A16/40)
USB_D+: JP3.3
USB_D-: JP3.4
UVCC: IR.6, IR1.6, JP3.2, JP4.1

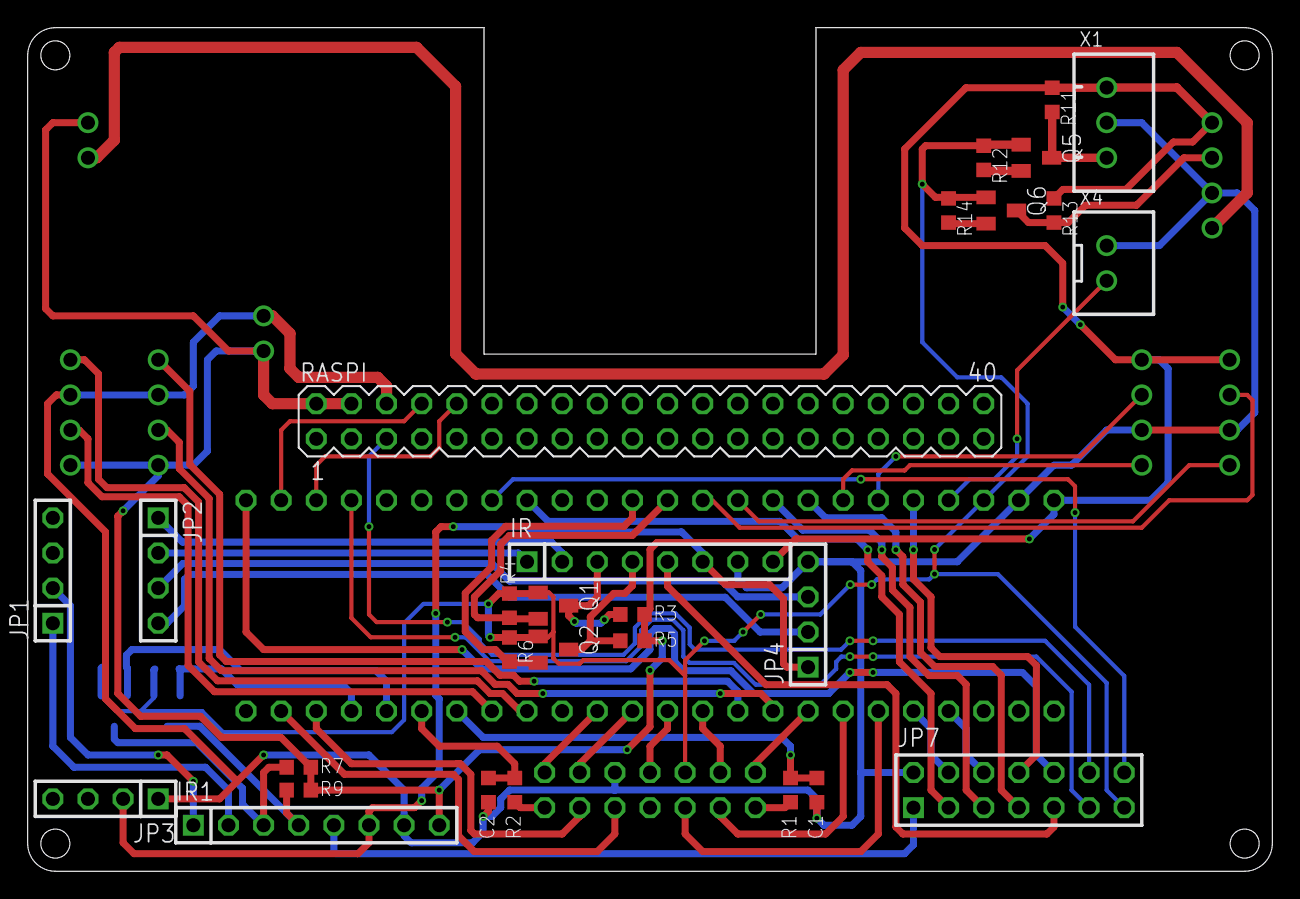
[picture p28: board board/mainboard/untitled.brd from above]

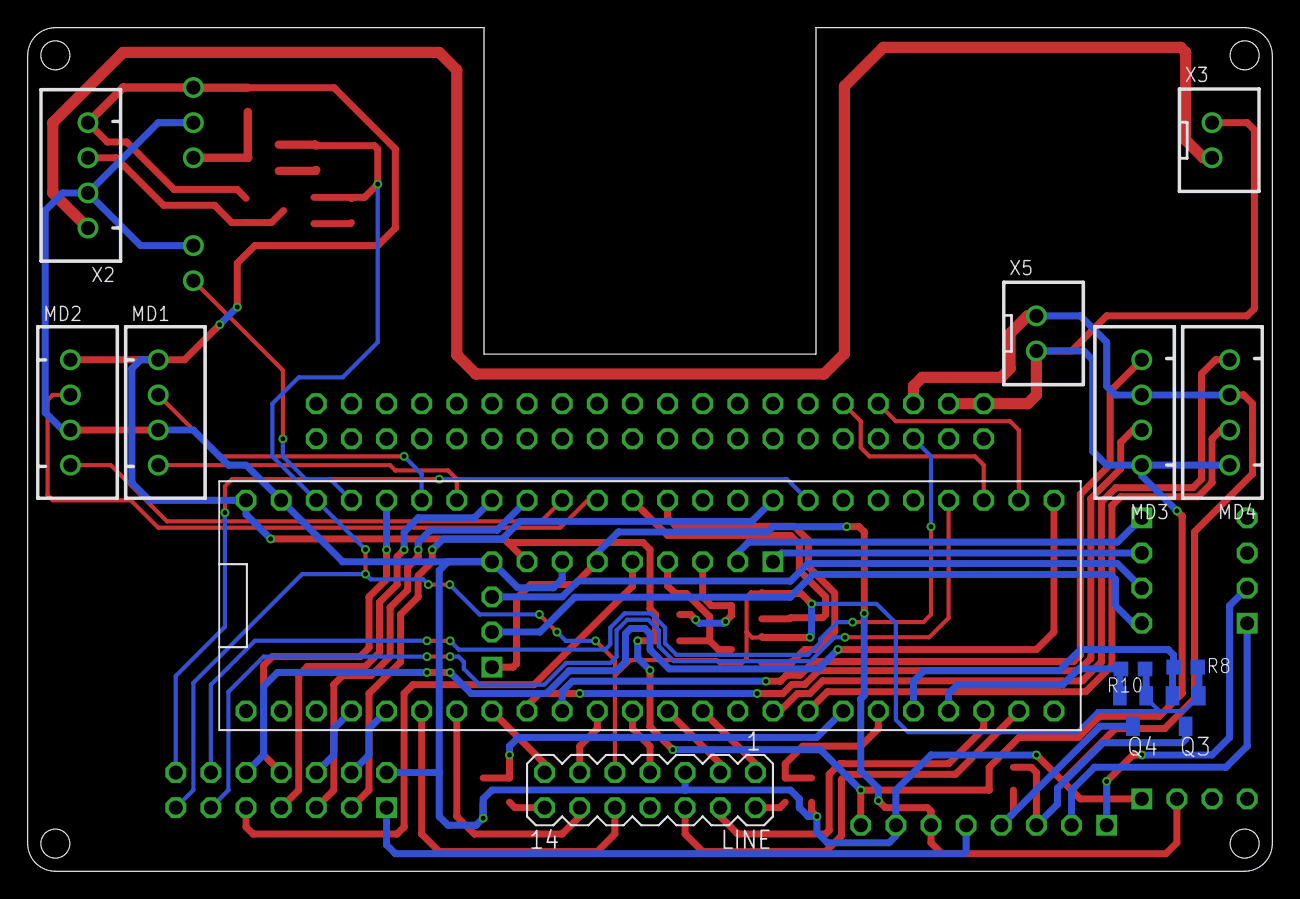
[picture p29: board board/mainboard/untitled.brd from below]

Board: 2 copper layers, 90.0 x 61.0 mm, 41 parts (13 on the bottom side), 59 nets.
