hirame-tech/RCJ2023/board/solenoid_board/untitled.brd

## EAGLE design board/solenoid_board/untitled.brd (2022-12-12)

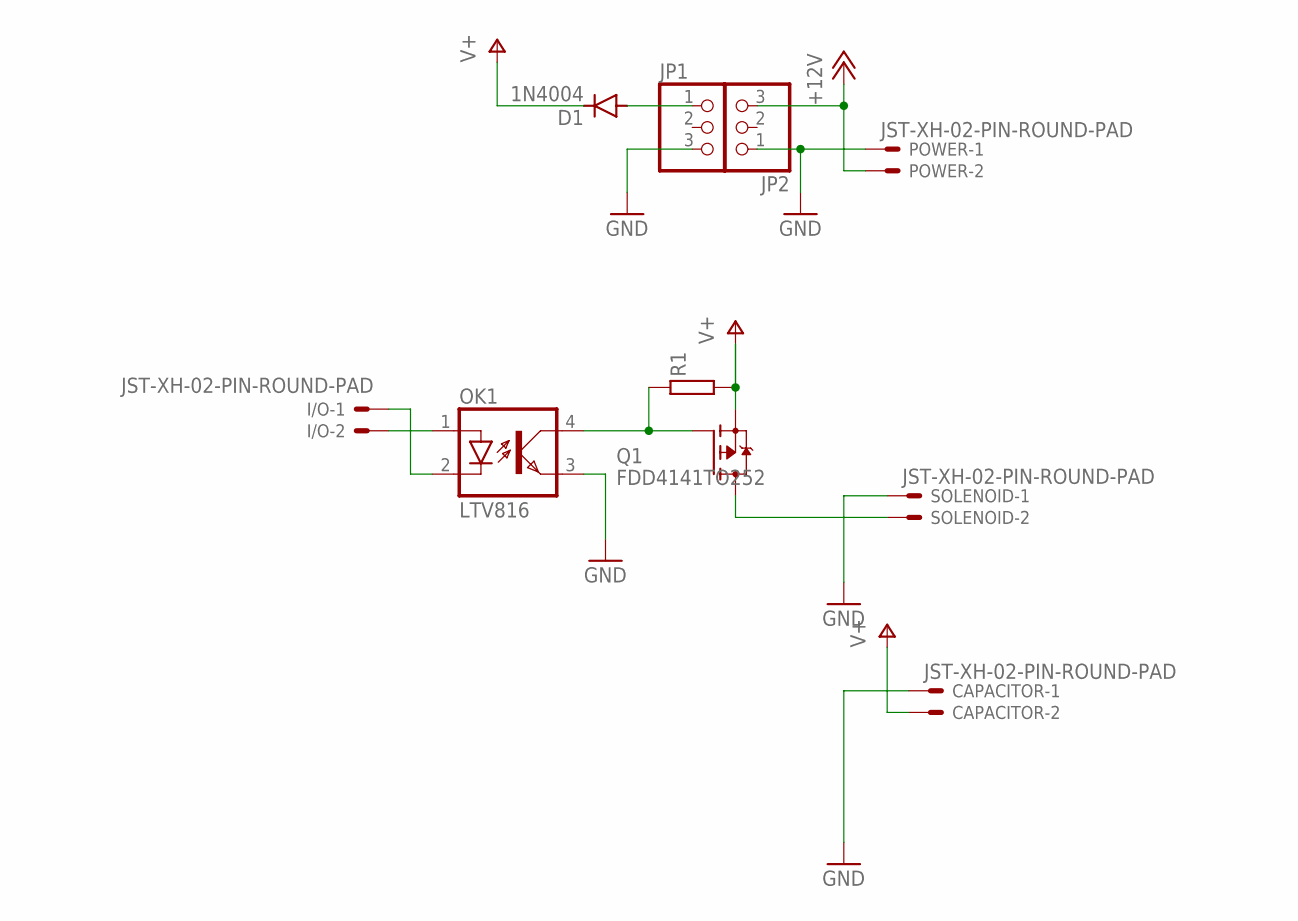
[picture p30: schematic untitled.sch]

Parts:
CAPACITOR: JST-XH-02-PIN-ROUND-PAD; JST-XH-02-PACKAGE-ROUND-PAD
D1: 1N4004; DO41-10
I/O: JST-XH-02-PIN-ROUND-PAD; JST-XH-02-PACKAGE-ROUND-PAD
JP1, JP2: PINHD-1X3; 1X03
OK1: LTV816; DIL04
POWER: JST-XH-02-PIN-ROUND-PAD; JST-XH-02-PACKAGE-ROUND-PAD
Q1: FDD4141TO252; TO252
R1: RESISTOR1608; SMD1608
SOLENOID: JST-XH-02-PIN-ROUND-PAD; JST-XH-02-PACKAGE-ROUND-PAD

Connections:
+12V: JP2.3, POWER.2
GND: CAPACITOR.1, JP1.3, JP2.1, OK1.3 (EMIT), POWER.1, SOLENOID.1
unnamed: Q1.3 (D), SOLENOID.2
unnamed: OK1.4 (COL), Q1.1 (G), R1.1
unnamed: I/O.2, OK1.1 (A)
unnamed: D1.A, JP1.1
unnamed: I/O.1, OK1.2 (C)
V+: CAPACITOR.2, D1.C, Q1.2 (S), R1.2

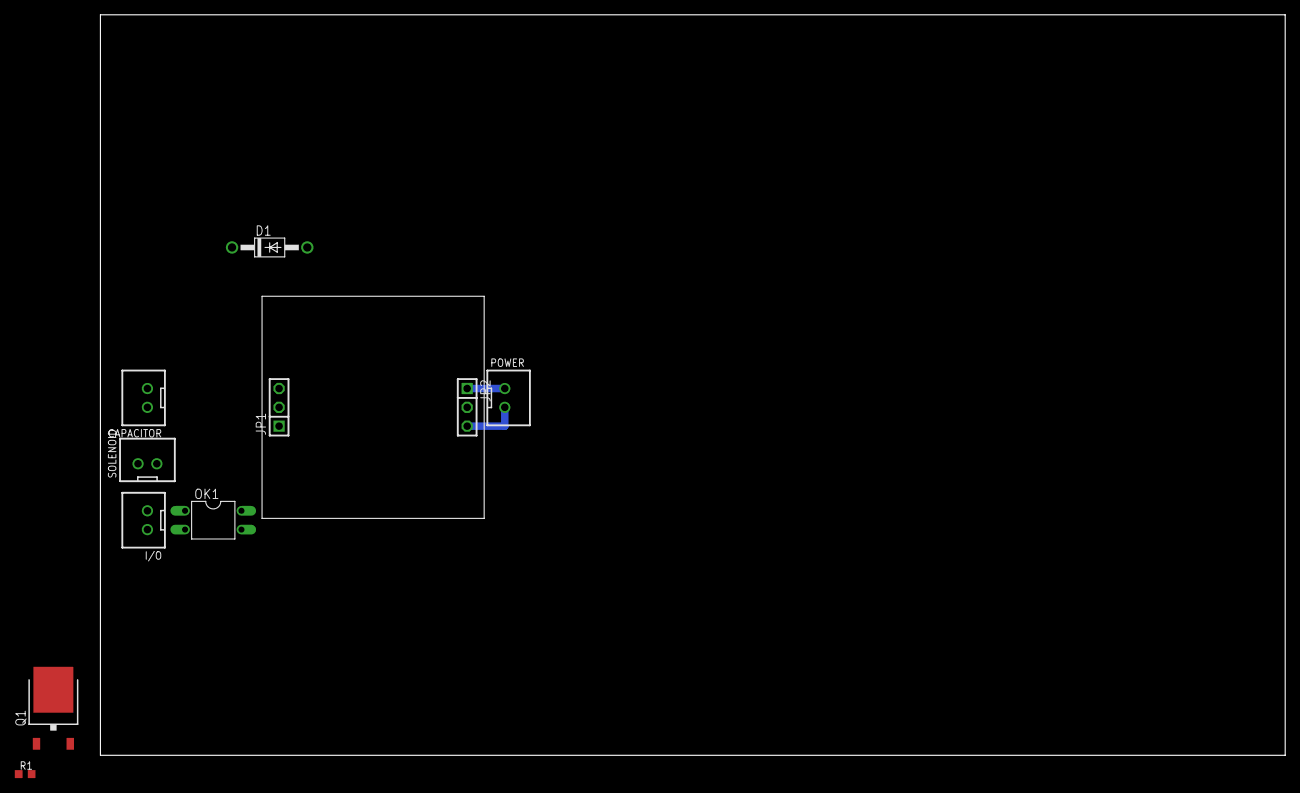
[picture p31: board board/solenoid_board/untitled.brd from above]

Board: 2 copper layers, 160.0 x 100.0 mm, 10 parts (0 on the bottom side), 8 nets.
