hirame-tech/RCJ2023/board/power_supply/untitled.brd

## EAGLE design board/power_supply/untitled.brd (2022-12-12)

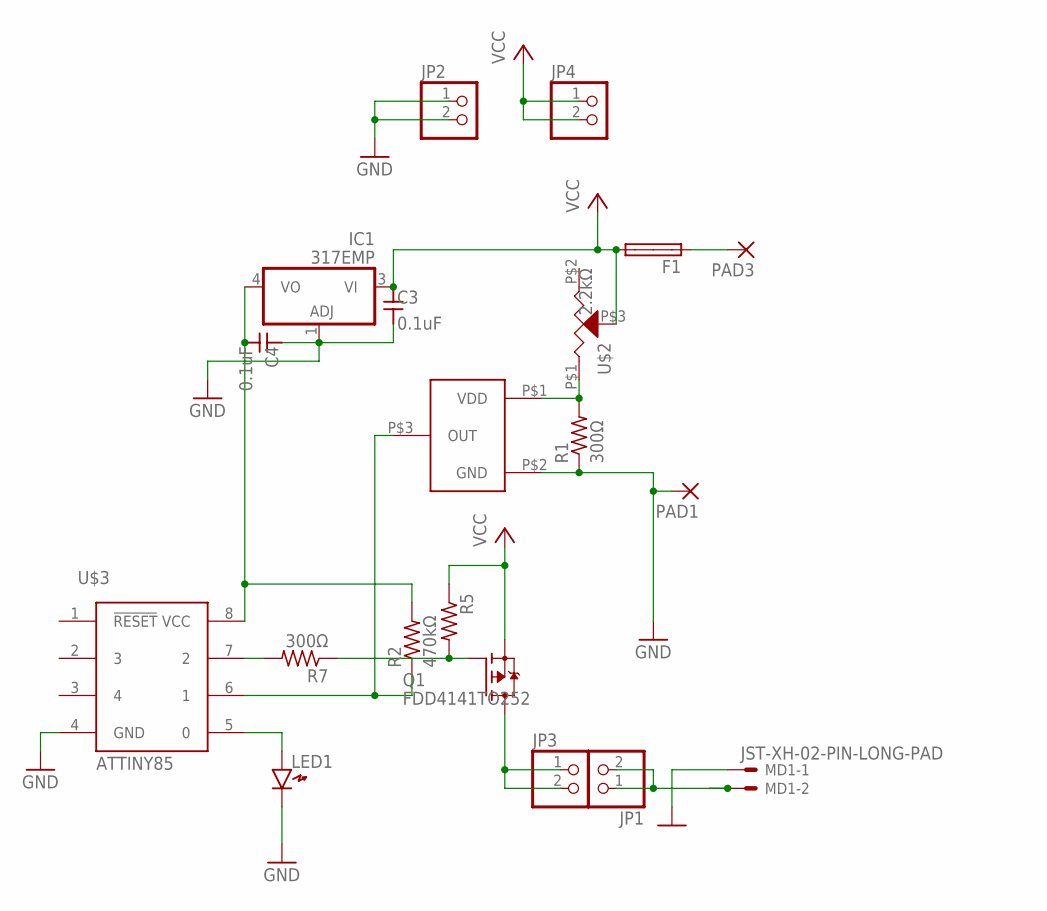
[picture p32: schematic untitled.sch]

Parts:
C3, C4: 0.1uF; SMD1608
F1: SH32
IC1: 317EMP; SOT223
JP1, JP2, JP3, JP4: PINHD-1X2; 1X02
LED1: LED1608
MD1: JST-XH-02-PIN-LONG-PAD; JST-XH-02-PACKAGE-LONG-PAD
PAD1, PAD3: 3,81/1,4
Q1: FDD4141TO252; TO252
R1, R7: 300Ω; M2012
R2: 470kΩ; M2012
R5: 10k; M2012
U$1: R3111N211A
U$2: 2.2kΩ; SMD-R-TRIM
U$3: ATTINY85; 8P3

Connections:
GND: C3.2, C4.1, IC1.1 (ADJ), JP2.1, JP2.2, LED1.K, MD1.1, PAD1.1, R1.1, U$1.P$2 (GND), U$3.4 (GND)
unnamed: R1.2, U$1.P$1 (VDD), U$2.P$1 (3)
unnamed: Q1.1 (G), R5.2, R7.1
unnamed: F1.1A, PAD3.1
unnamed: R2.1, U$1.P$3 (OUT), U$3.6 (1)
unnamed: JP3.1, JP3.2, Q1.3 (D)
unnamed: LED1.A, U$3.5 (0)
unnamed: JP1.1, JP1.2, MD1.2
unnamed: R7.2, U$3.7 (2)
unnamed: C4.2, IC1.4 (VO), R2.2, U$3.8 (VCC)
VCC: C3.1, F1.2A, IC1.3 (VI), JP4.1, JP4.2, Q1.2 (S), R5.1, U$2.P$3 (2)

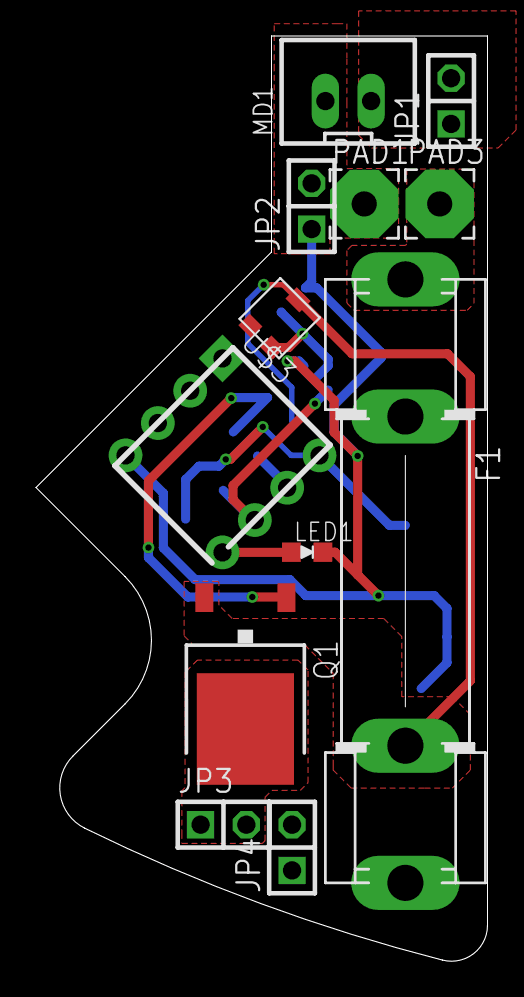
[picture p33: board board/power_supply/untitled.brd from above]

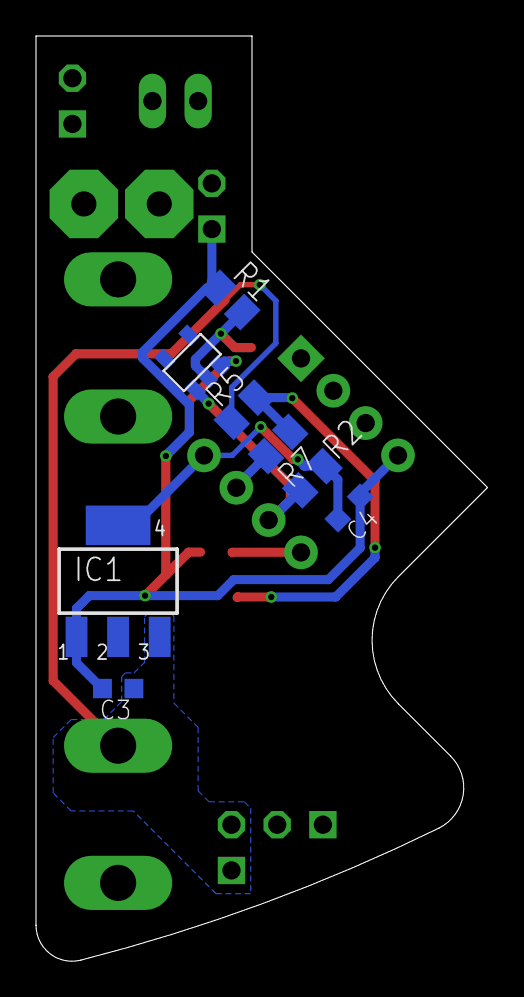
[picture p34: board board/power_supply/untitled.brd from below]

Board: 2 copper layers, 25.1 x 51.4 mm, 20 parts (8 on the bottom side), 11 nets.
