hirame-tech/RCJ2023/board/IRsensor/untitled.brd

## EAGLE design board/IRsensor/untitled.brd (2022-12-12)

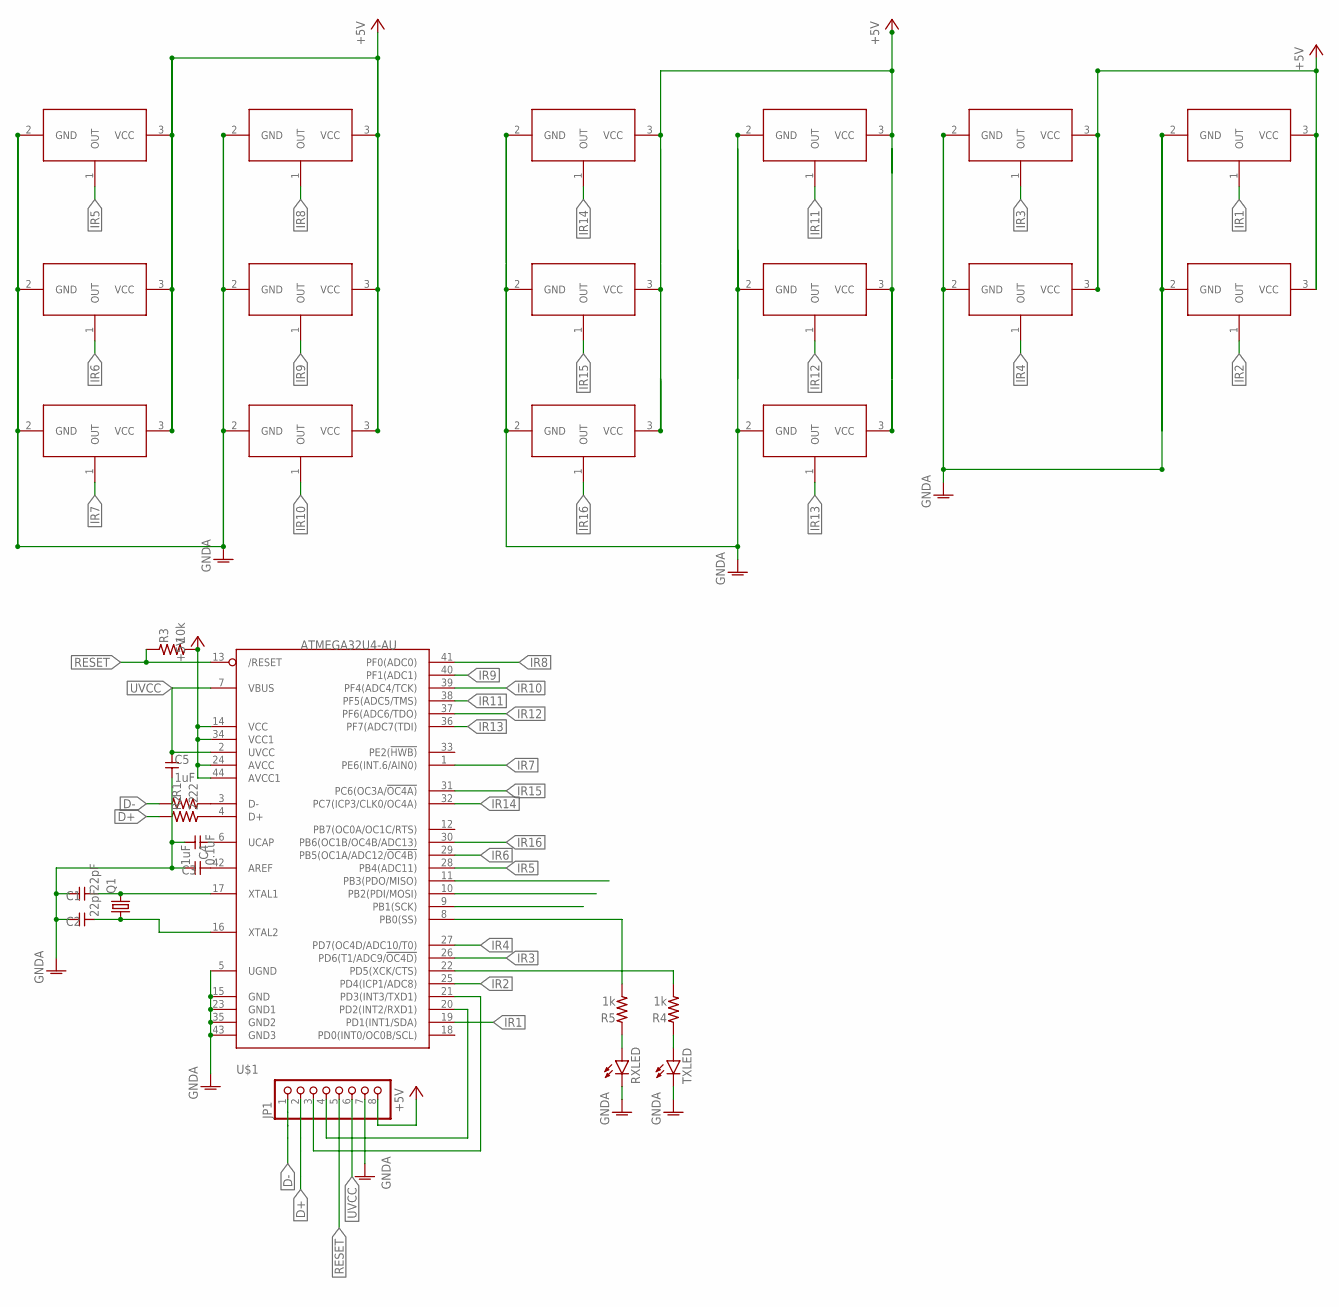
[picture p35: schematic untitled.sch]

Parts:
C1, C2: 22pF; SMD1608
C3: 0.1uF; SMD1608
C4, C5: 1uF; SMD1608
IR1, IR2, IR3, IR4, IR5, IR6, IR7, IR8, IR9, IR10, IR11, IR12, IR13, IR14, IR15, IR16: IRM2121-A538; IRM_V
JP1: PINHD-1X8BIG; 1X08-BIG
Q1: CRYSTALHC49S; HC49/S
R1, R2: 22; SMD1608
R3: 10k; SMD1608
R4, R5: 1k; SMD1608
RXLED: LEDSML0603; SML0603
TXLED: LEDSML0603; SML0603
U$1: ATMEGA32U4-AU; TQFP44

Connections:
+5V: IR1.3 (VCC), IR2.3 (VCC), IR3.3 (VCC), IR4.3 (VCC), IR5.3 (VCC), IR6.3 (VCC), IR7.3 (VCC), IR8.3 (VCC), IR9.3 (VCC), IR10.3 (VCC), IR11.3 (VCC), IR12.3 (VCC), IR13.3 (VCC), IR14.3 (VCC), IR15.3 (VCC), IR16.3 (VCC), JP1.8, R3.2, U$1.14 (VCC), U$1.24 (AVCC), U$1.34 (VCC1), U$1.44 (AVCC1)
D+: JP1.2, R2.1
D-: JP1.1, R1.1
GNDA: C1.1, C2.1, C3.1, C4.2, C5.2, IR1.2 (GND), IR2.2 (GND), IR3.2 (GND), IR4.2 (GND), IR5.2 (GND), IR6.2 (GND), IR7.2 (GND), IR8.2 (GND), IR9.2 (GND), IR10.2 (GND), IR11.2 (GND), IR12.2 (GND), IR13.2 (GND), IR14.2 (GND), IR15.2 (GND), IR16.2 (GND), JP1.7, RXLED.C, TXLED.C, U$1.5 (UGND), U$1.15 (GND), U$1.23 (GND1), U$1.35 (GND2), U$1.43 (GND3)
IR1: IR1.1 (OUT), U$1.19 (PD1(INT1/SDA))
IR2: IR2.1 (OUT), U$1.25 (PD4(ICP1/ADC8))
IR3: IR3.1 (OUT), U$1.26 (PD6(T1/ADC9/!OC4D))
IR4: IR4.1 (OUT), U$1.27 (PD7(OC4D/ADC10/T0))
IR5: IR5.1 (OUT), U$1.28 (PB4(ADC11))
IR6: IR6.1 (OUT), U$1.29 (PB5(OC1A/ADC12/!OC4B))
IR7: IR7.1 (OUT), U$1.1 (PE6(INT.6/AIN0))
IR8: IR8.1 (OUT), U$1.41 (PF0(ADC0))
IR9: IR9.1 (OUT), U$1.40 (PF1(ADC1))
IR10: IR10.1 (OUT), U$1.39 (PF4(ADC4/TCK))
IR11: IR11.1 (OUT), U$1.38 (PF5(ADC5/TMS))
IR12: IR12.1 (OUT), U$1.37 (PF6(ADC6/TDO))
IR13: IR13.1 (OUT), U$1.36 (PF7(ADC7(TDI))
IR14: IR14.1 (OUT), U$1.32 (PC7(ICP3/CLK0/OC4A))
IR15: IR15.1 (OUT), U$1.31 (PC6(OC3A/!OC4A))
IR16: IR16.1 (OUT), U$1.30 (PB6(OC1B/OC4B/ADC13))
unnamed: JP1.4, U$1.20 (PD2(INT2/RXD1))
unnamed: JP1.3, U$1.21 (PD3(INT3/TXD1))
unnamed: C3.2, U$1.42 (AREF)
unnamed: C4.1, U$1.6 (UCAP)
unnamed: C1.2, Q1.2, U$1.17 (XTAL1)
unnamed: C2.2, Q1.1, U$1.16 (XTAL2)
unnamed: R1.2, U$1.3 (D-)
unnamed: R2.2, U$1.4 (D+)
unnamed: R4.2, U$1.22 (PD5(XCK/CTS))
unnamed: R4.1, TXLED.A
unnamed: R5.1, RXLED.A
unnamed: R5.2, U$1.8 (PB0(SS))
RESET: JP1.5, R3.1, U$1.13 (/RESET)
UVCC: C5.1, JP1.6, U$1.2 (UVCC), U$1.7 (VBUS)

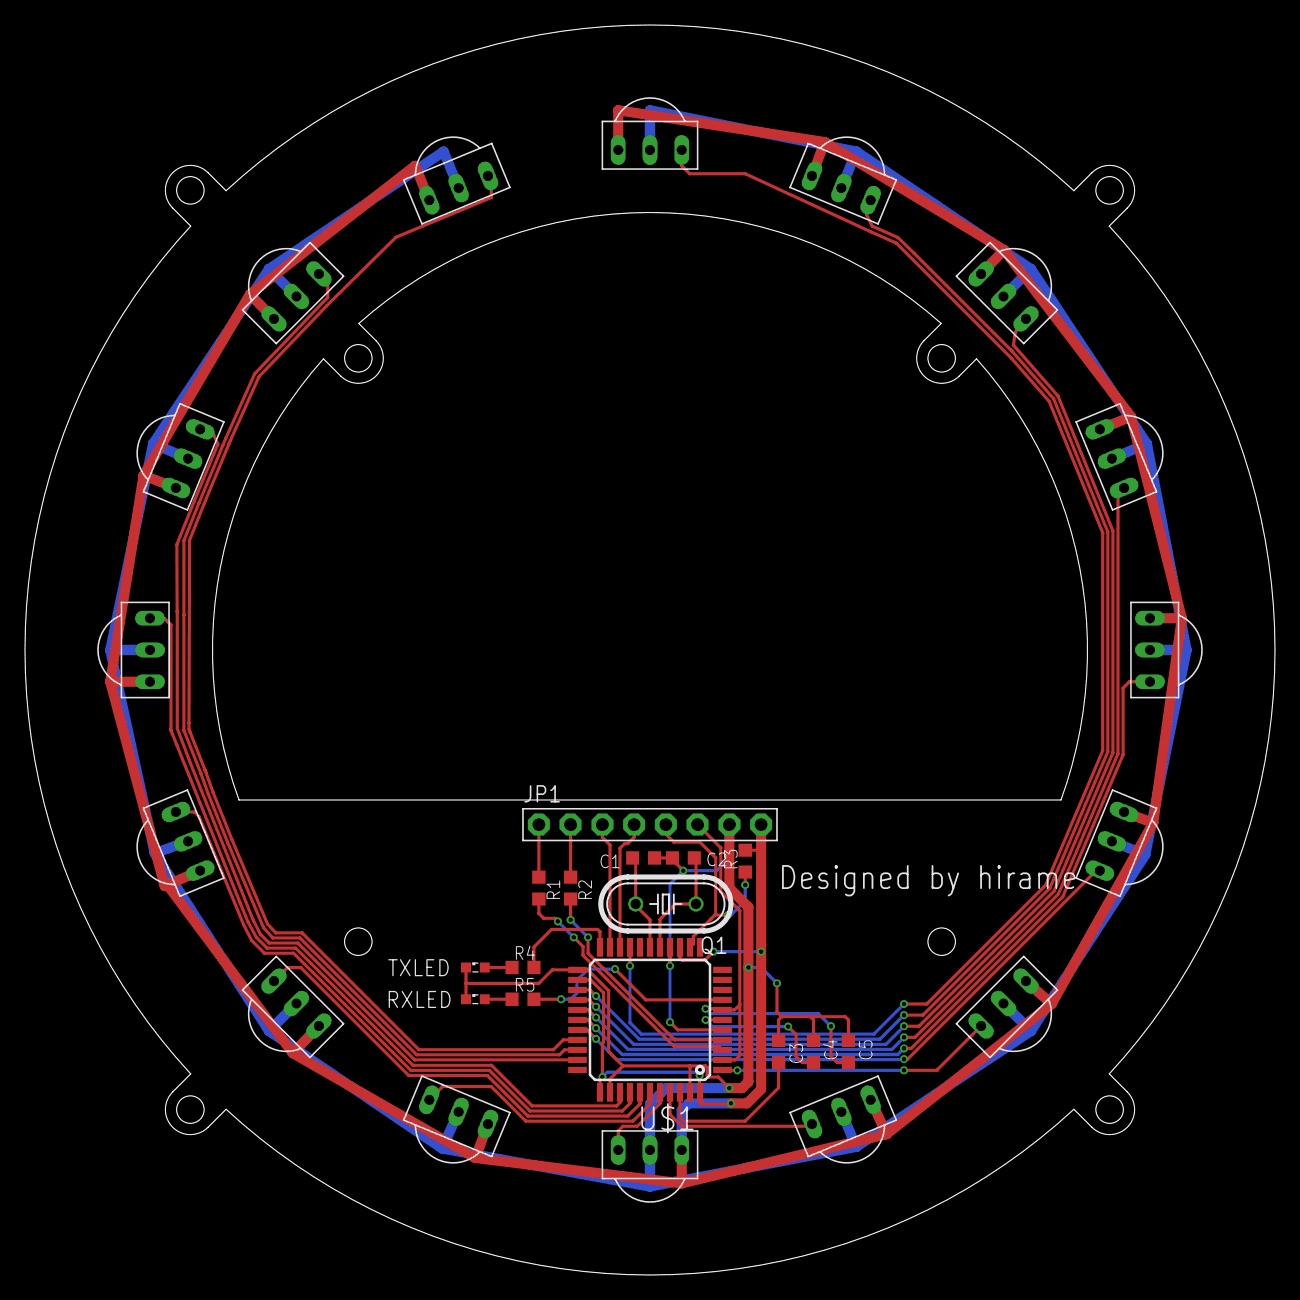
[picture p36: board board/IRsensor/untitled.brd from above]

Board: 2 copper layers, 100.0 x 100.0 mm, 31 parts (0 on the bottom side), 34 nets.
