hirame-tech/RCJ2023/board/BLDCdriver_test/encorder/encorder.brd

## EAGLE design board/BLDCdriver_test/encorder/encorder.brd (2022-12-12)

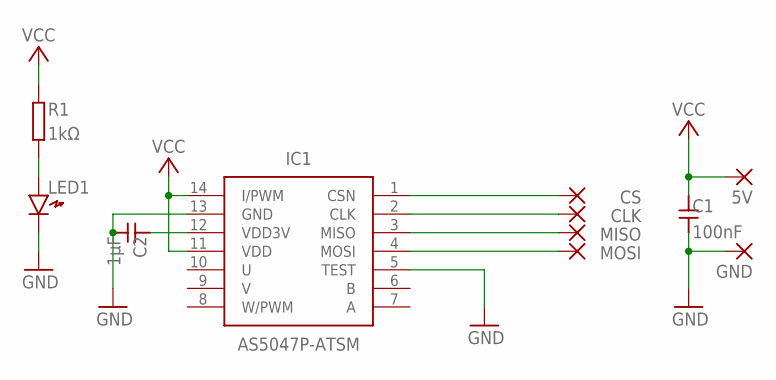
[picture p37: schematic encorder.sch]

Parts:
5V: SMD2; SMD1,27-2,54
C1: 100nF; SMD1608
C2: 1µF; SMD1608
CLK: SMD2; SMD1,27-2,54
CS: SMD2; SMD1,27-2,54
GND: SMD2; SMD1,27-2,54
IC1: AS5047P-ATSM; SOP65P640X120-14N
LED1: LED1608
MISO: SMD2; SMD1,27-2,54
MOSI: SMD2; SMD1,27-2,54
R1: 1kΩ; SMD1608

Connections:
GND: C1.2, C2.2, GND.1, IC1.5 (TEST), IC1.13 (GND), LED1.K
unnamed: C2.1, IC1.12 (VDD3V)
unnamed: CS.1, IC1.1 (CSN)
unnamed: CLK.1, IC1.2 (CLK)
unnamed: IC1.3 (MISO), MISO.1
unnamed: IC1.4 (MOSI), MOSI.1
unnamed: LED1.A, R1.2
VCC: 5V.1, C1.1, IC1.11 (VDD), IC1.14 (I/PWM), R1.1

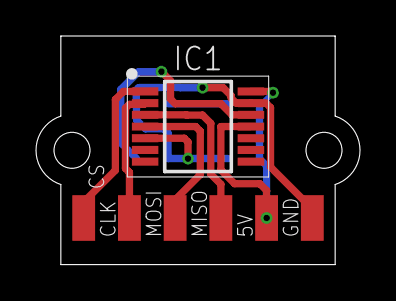
[picture p38: board encorder.brd from above]

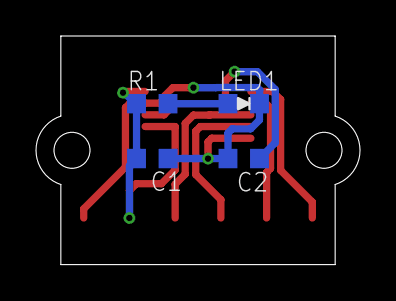
[picture p39: board encorder.brd from below]

Board: 2 copper layers, 18.0 x 12.7 mm, 11 parts (4 on the bottom side), 8 nets.
