hirame-tech/RCJ2023/board/line_sensor_test/untitled.brd

## EAGLE design board/line_sensor_test/untitled.brd (2022-12-12)

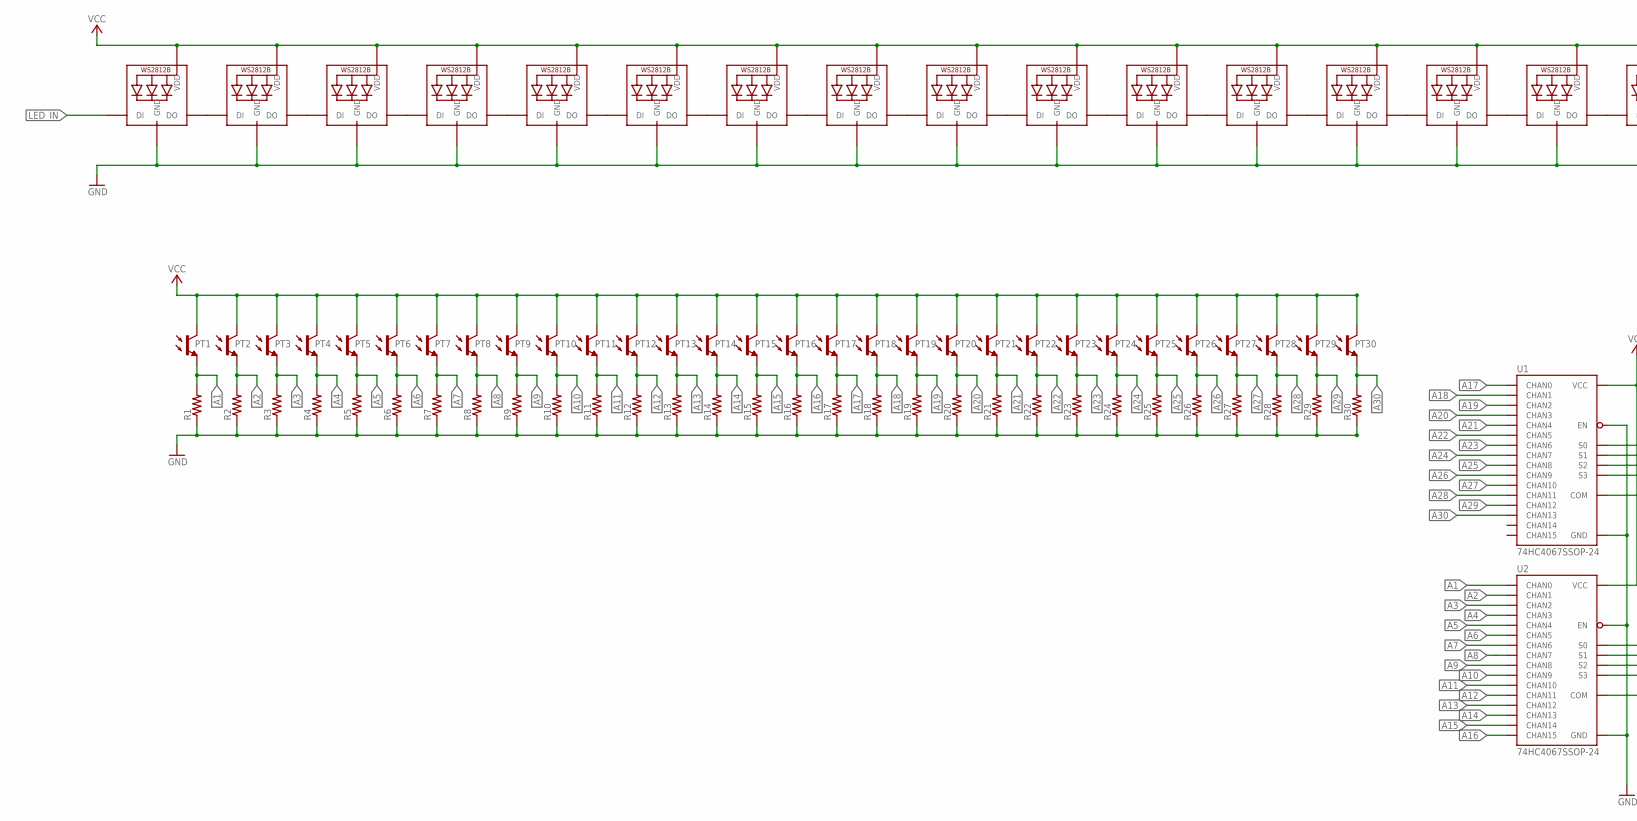
[picture p40: schematic untitled.sch, part in row 1, column 1]

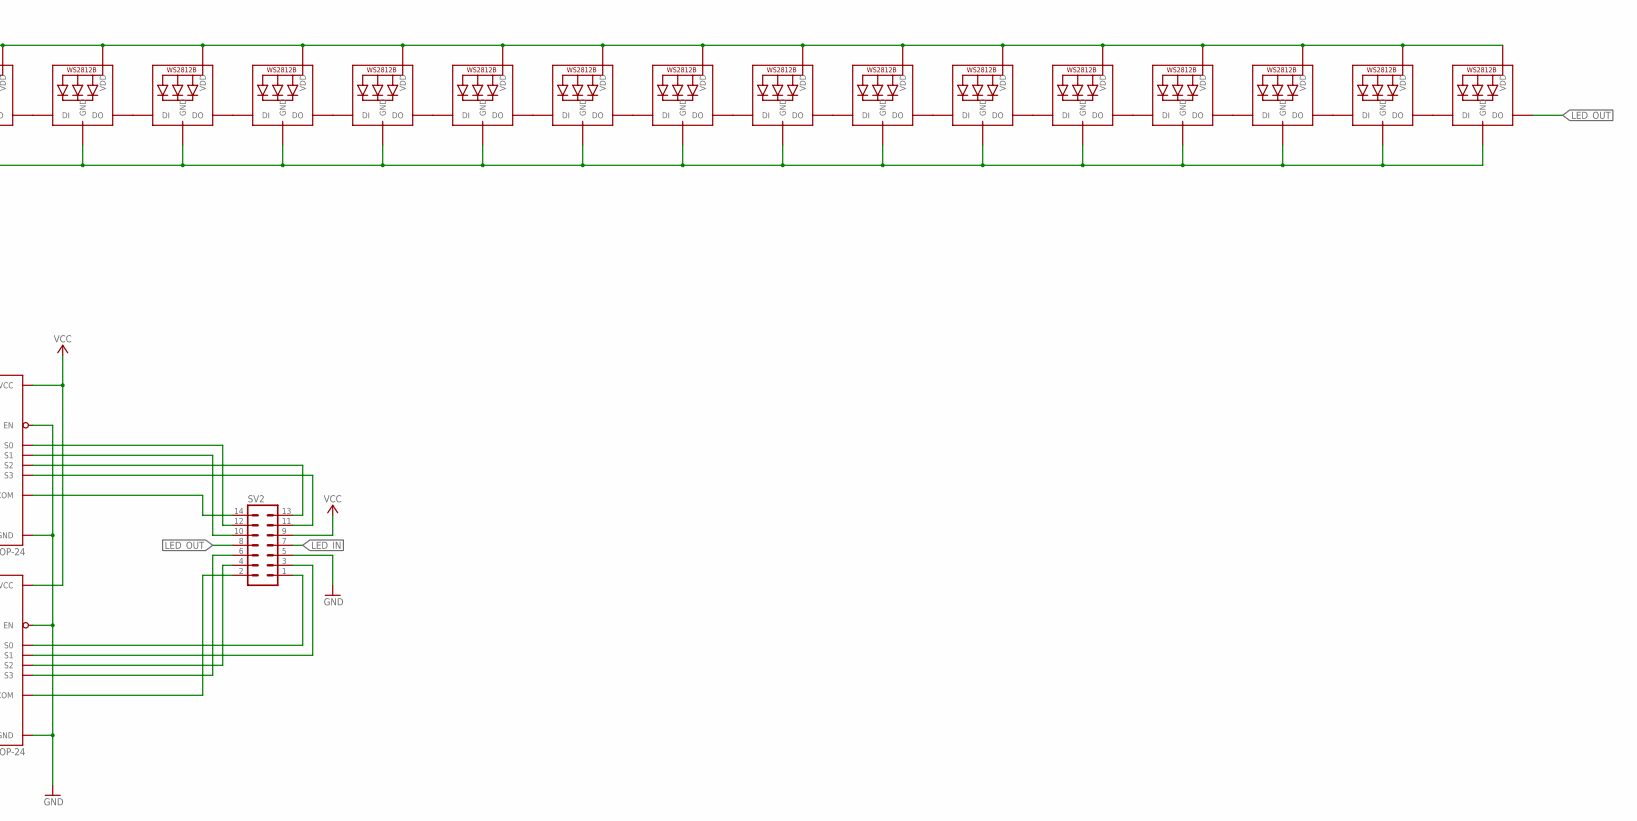
[picture p41: schematic untitled.sch, part in row 1, column 2]

Parts:
LED1, LED2, LED3, LED4, LED5, LED6, LED7, LED8, LED9, LED10, LED11, LED12, LED13, LED14, LED15, LED16, LED17, LED18, LED19, LED20, LED21, LED22, LED23, LED24, LED25, LED26, LED27, LED28, LED29, LED30: WS2812B_5050N; WS2812B-NARROW
PT1, PT2, PT3, PT4, PT5, PT6, PT7, PT8, PT9, PT10, PT11, PT12, PT13, PT14, PT15, PT16, PT17, PT18, PT19, PT20, PT21, PT22, PT23, PT24, PT25, PT26, PT27, PT28, PT29, PT30: TPS611; NJL7502L
R1, R2, R3, R4, R5, R6, R7, R8, R9, R10, R11, R12, R13, R14, R15, R16, R17, R18, R19, R20, R21, R22, R23, R24, R25, R26, R27, R28, R29, R30: R-US_M2012; M2012
SV2: MA07-2
U1, U2: 74HC4067SSOP-24; SSOP24

Connections:
A1: PT1.E, R1.2, U2.9 (CHAN0)
A2: PT2.E, R2.2, U2.8 (CHAN1)
A3: PT3.E, R3.2, U2.7 (CHAN2)
A4: PT4.E, R4.2, U2.6 (CHAN3)
A5: PT5.E, R5.2, U2.5 (CHAN4)
A6: PT6.E, R6.2, U2.4 (CHAN5)
A7: PT7.E, R7.2, U2.3 (CHAN6)
A8: PT8.E, R8.2, U2.2 (CHAN7)
A9: PT9.E, R9.2, U2.23 (CHAN8)
A10: PT10.E, R10.2, U2.22 (CHAN9)
A11: PT11.E, R11.2, U2.21 (CHAN10)
A12: PT12.E, R12.2, U2.20 (CHAN11)
A13: PT13.E, R13.2, U2.19 (CHAN12)
A14: PT14.E, R14.2, U2.18 (CHAN13)
A15: PT15.E, R15.2, U2.17 (CHAN14)
A16: PT16.E, R16.2, U2.16 (CHAN15)
A17: PT17.E, R17.2, U1.9 (CHAN0)
A18: PT18.E, R18.2, U1.8 (CHAN1)
A19: PT19.E, R19.2, U1.7 (CHAN2)
A20: PT20.E, R20.2, U1.6 (CHAN3)
A21: PT21.E, R21.2, U1.5 (CHAN4)
A22: PT22.E, R22.2, U1.4 (CHAN5)
A23: PT23.E, R23.2, U1.3 (CHAN6)
A24: PT24.E, R24.2, U1.2 (CHAN7)
A25: PT25.E, R25.2, U1.23 (CHAN8)
A26: PT26.E, R26.2, U1.22 (CHAN9)
A27: PT27.E, R27.2, U1.21 (CHAN10)
A28: PT28.E, R28.2, U1.20 (CHAN11)
A29: PT29.E, R29.2, U1.19 (CHAN12)
A30: PT30.E, R30.2, U1.18 (CHAN13)
AIN0: SV2.14, U1.1 (COM)
AIN1: SV2.2, U2.1 (COM)
GND: LED1.3-GND (GND), LED2.3-GND (GND), LED3.3-GND (GND), LED4.3-GND (GND), LED5.3-GND (GND), LED6.3-GND (GND), LED7.3-GND (GND), LED8.3-GND (GND), LED9.3-GND (GND), LED10.3-GND (GND), LED11.3-GND (GND), LED12.3-GND (GND), LED13.3-GND (GND), LED14.3-GND (GND), LED15.3-GND (GND), LED16.3-GND (GND), LED17.3-GND (GND), LED18.3-GND (GND), LED19.3-GND (GND), LED20.3-GND (GND), LED21.3-GND (GND), LED22.3-GND (GND), LED23.3-GND (GND), LED24.3-GND (GND), LED25.3-GND (GND), LED26.3-GND (GND), LED27.3-GND (GND), LED28.3-GND (GND), LED29.3-GND (GND), LED30.3-GND (GND), R1.1, R2.1, R3.1, R4.1, R5.1, R6.1, R7.1, R8.1, R9.1, R10.1, R11.1, R12.1, R13.1, R14.1, R15.1, R16.1, R17.1, R18.1, R19.1, R20.1, R21.1, R22.1, R23.1, R24.1, R25.1, R26.1, R27.1, R28.1, R29.1, R30.1, SV2.5, U1.12 (GND), U1.15 (EN), U2.12 (GND), U2.15 (EN)
LED_IN: LED1.4-DIN (DI), SV2.7
LED_OUT: LED30.2-DOUT (DO), SV2.8
unnamed: LED1.2-DOUT (DO), LED2.4-DIN (DI)
unnamed: LED2.2-DOUT (DO), LED3.4-DIN (DI)
unnamed: LED3.2-DOUT (DO), LED4.4-DIN (DI)
unnamed: LED4.2-DOUT (DO), LED5.4-DIN (DI)
unnamed: LED6.2-DOUT (DO), LED7.4-DIN (DI)
unnamed: SV2.13, U1.14 (S2)
unnamed: SV2.11, U1.13 (S3)
unnamed: SV2.6, U2.13 (S3)
unnamed: SV2.4, U2.14 (S2)
unnamed: LED7.2-DOUT (DO), LED8.4-DIN (DI)
unnamed: SV2.3, U2.11 (S1)
unnamed: SV2.1, U2.10 (S0)
unnamed: SV2.10, U1.11 (S1)
unnamed: SV2.12, U1.10 (S0)
unnamed: LED8.2-DOUT (DO), LED9.4-DIN (DI)
unnamed: LED9.2-DOUT (DO), LED10.4-DIN (DI)
unnamed: LED5.2-DOUT (DO), LED6.4-DIN (DI)
unnamed: LED11.2-DOUT (DO), LED12.4-DIN (DI)
unnamed: LED12.2-DOUT (DO), LED13.4-DIN (DI)
unnamed: LED13.2-DOUT (DO), LED14.4-DIN (DI)
unnamed: LED14.2-DOUT (DO), LED15.4-DIN (DI)
unnamed: LED10.2-DOUT (DO), LED11.4-DIN (DI)
unnamed: LED16.2-DOUT (DO), LED17.4-DIN (DI)
unnamed: LED17.2-DOUT (DO), LED18.4-DIN (DI)
unnamed: LED18.2-DOUT (DO), LED19.4-DIN (DI)
unnamed: LED19.2-DOUT (DO), LED20.4-DIN (DI)
unnamed: LED15.2-DOUT (DO), LED16.4-DIN (DI)
unnamed: LED21.2-DOUT (DO), LED22.4-DIN (DI)
unnamed: LED22.2-DOUT (DO), LED23.4-DIN (DI)
unnamed: LED23.2-DOUT (DO), LED24.4-DIN (DI)
unnamed: LED24.2-DOUT (DO), LED25.4-DIN (DI)
unnamed: LED20.2-DOUT (DO), LED21.4-DIN (DI)
unnamed: LED26.2-DOUT (DO), LED27.4-DIN (DI)
unnamed: LED27.2-DOUT (DO), LED28.4-DIN (DI)
unnamed: LED28.2-DOUT (DO), LED29.4-DIN (DI)
unnamed: LED29.2-DOUT (DO), LED30.4-DIN (DI)
unnamed: LED25.2-DOUT (DO), LED26.4-DIN (DI)
VCC: LED1.1-VDD (VDD), LED2.1-VDD (VDD), LED3.1-VDD (VDD), LED4.1-VDD (VDD), LED5.1-VDD (VDD), LED6.1-VDD (VDD), LED7.1-VDD (VDD), LED8.1-VDD (VDD), LED9.1-VDD (VDD), LED10.1-VDD (VDD), LED11.1-VDD (VDD), LED12.1-VDD (VDD), LED13.1-VDD (VDD), LED14.1-VDD (VDD), LED15.1-VDD (VDD), LED16.1-VDD (VDD), LED17.1-VDD (VDD), LED18.1-VDD (VDD), LED19.1-VDD (VDD), LED20.1-VDD (VDD), LED21.1-VDD (VDD), LED22.1-VDD (VDD), LED23.1-VDD (VDD), LED24.1-VDD (VDD), LED25.1-VDD (VDD), LED26.1-VDD (VDD), LED27.1-VDD (VDD), LED28.1-VDD (VDD), LED29.1-VDD (VDD), LED30.1-VDD (VDD), PT1.C, PT2.C, PT3.C, PT4.C, PT5.C, PT6.C, PT7.C, PT8.C, PT9.C, PT10.C, PT11.C, PT12.C, PT13.C, PT14.C, PT15.C, PT16.C, PT17.C, PT18.C, PT19.C, PT20.C, PT21.C, PT22.C, PT23.C, PT24.C, PT25.C, PT26.C, PT27.C, PT28.C, PT29.C, PT30.C, SV2.9, U1.24 (VCC), U2.24 (VCC)

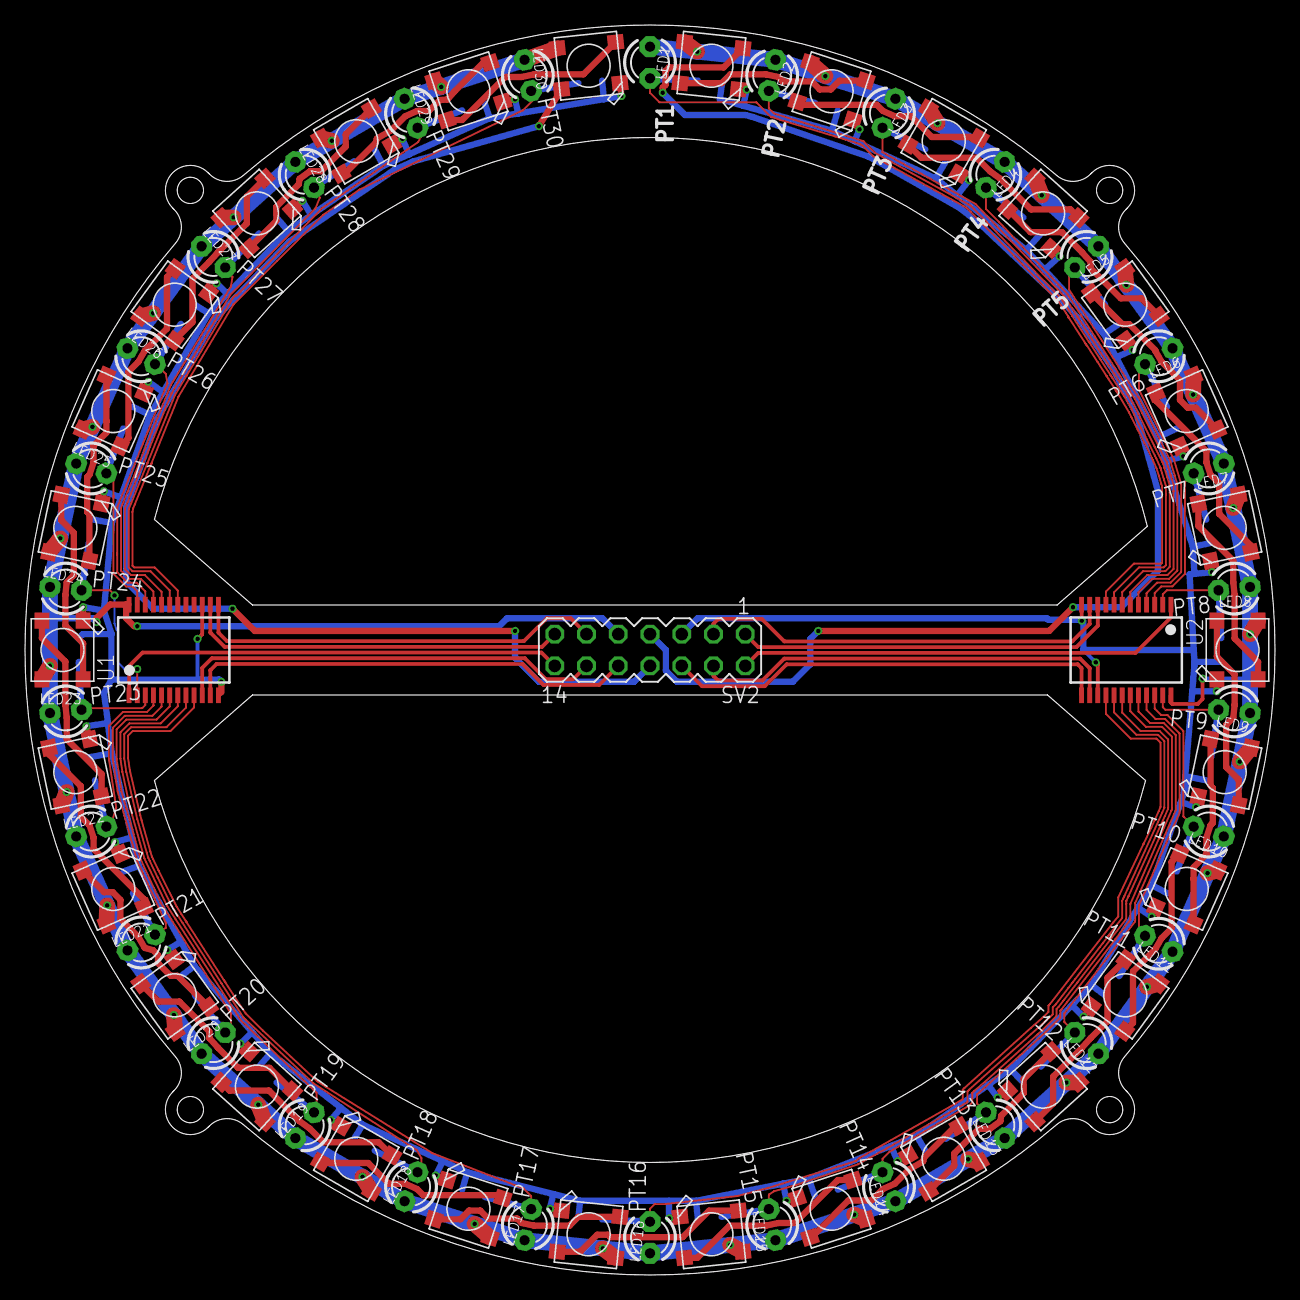
[picture p42: board board/line_sensor_test/untitled.brd from above]

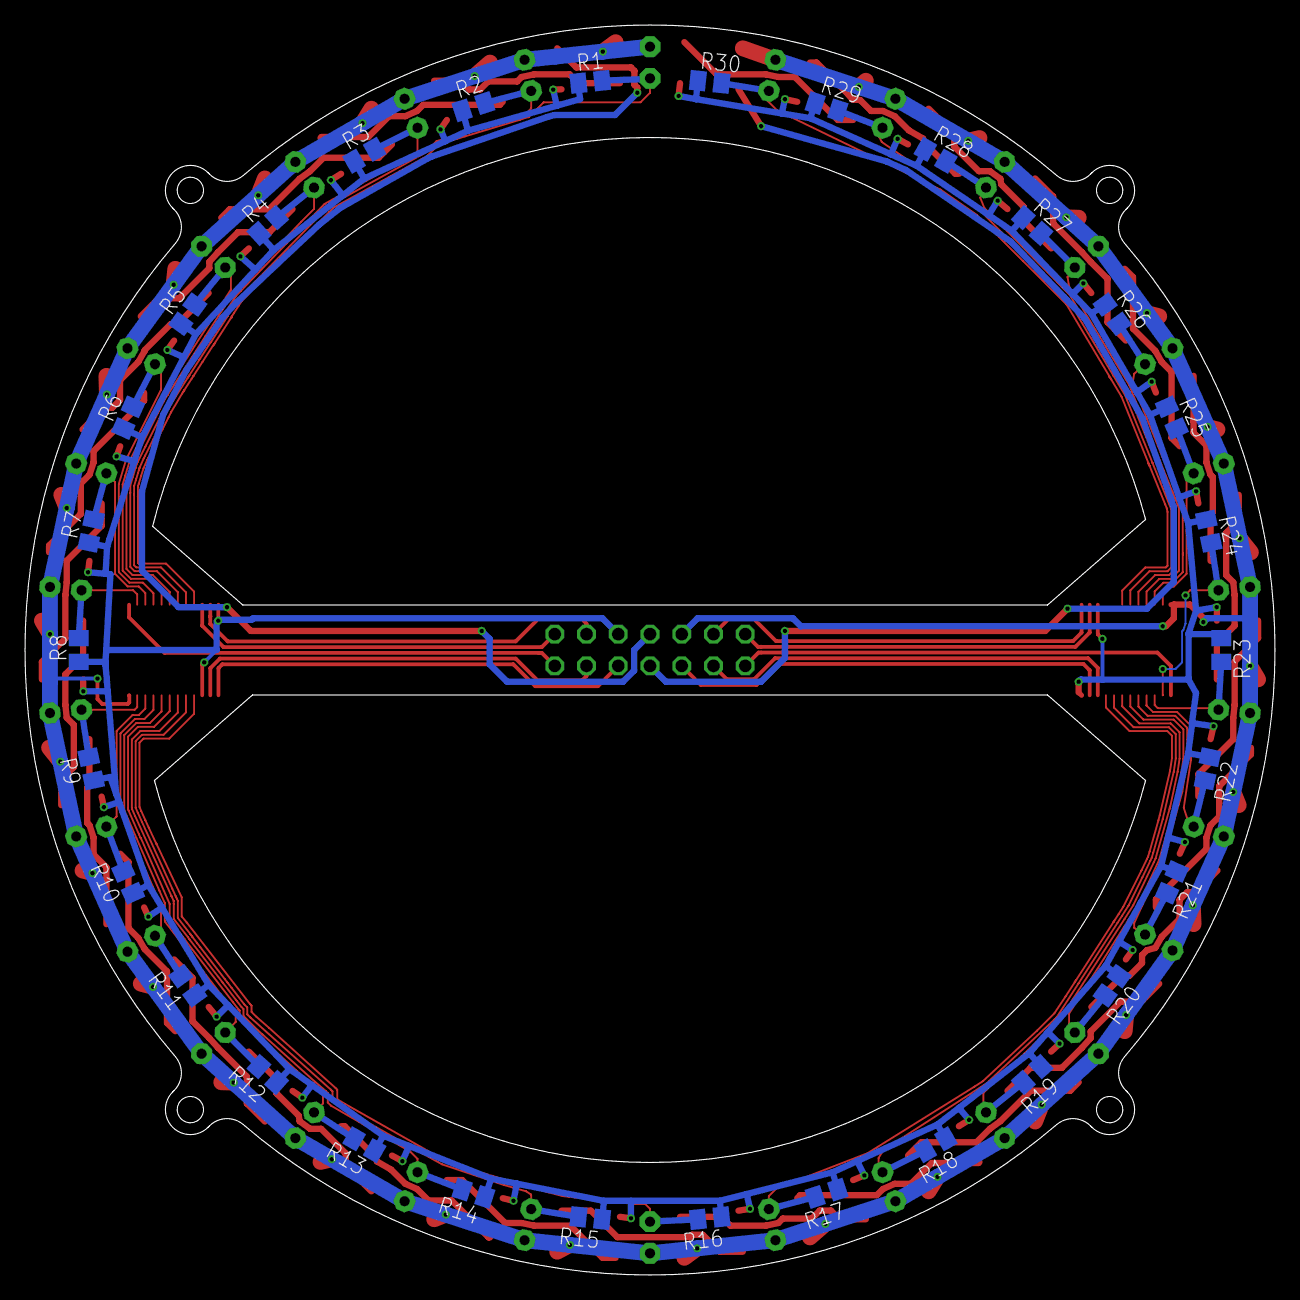
[picture p43: board board/line_sensor_test/untitled.brd from below]

Board: 2 copper layers, 100.0 x 100.0 mm, 93 parts (30 on the bottom side), 73 nets.
