hirame-tech/RCJ2023/software_test/line_sensor/src/main.cpp

#include <Adafruit_NeoPixel.h>
#include <Arduino.h>
#include <math.h>

#define BRIGHTNESS 255
#define LED_PIN 9

Adafruit_NeoPixel strip(30, LED_PIN, NEO_GRB + NEO_KHZ800);

void get_linesensor(int *pins, int *a_pins, int *value);

void get_rad(int data[], int threshold, float *angle, float *distance);

double degree_to_rad(int degree);//

void exit_judge(float *angle, float *distance);

int set_port[8] = {7, 8, 6, 10, 3, 2, 4, 5};
int read_port[2] = {A1, A0};

int sensor_value[30];  //読み込んだ値を格納

void set_pin() {
    int i;
    for (i = 0; i < 8; i++) {
        pinMode(set_port[i], OUTPUT);
    }
    pinMode(read_port[0], INPUT);  // 0~14
    pinMode(read_port[1], INPUT);  // 15~30
}

void setup() {
    Serial.begin(9600);
    strip.begin();
    strip.show();  // Turn OFF
    strip.setBrightness(BRIGHTNESS);
    set_pin();
}

void loop() {
    int threshold = 700;  // any value

    float aaangle, angle, distance;

    for (int i = 0; i < 30; i++) {
        strip.setPixelColor(i, strip.Color(0, 255, 0));
    }
    strip.show();

    get_linesensor(set_port, read_port, sensor_value);

    //以下を各ラインセンサ値を調べるときに用いる。
    /*for (int i = 0; i < 29; i++) {
        Serial.print(sensor_value[i]);
        Serial.print(",");
    }
    Serial.println(sensor_value[29]);*/

    get_rad(sensor_value, threshold, &angle, &distance);

    exit_judge(&angle, &distance);

    degree = (180 / PI) * angle;
    Serial.print(degree);
    Serial.print(",");
    Serial.println(distance);
}

/*
 * @brief get linesensor value
 * @param pins digitalpin number
 * @param a_pins analogpin number
 * @param value return sensor value
 */
void get_linesensor(int *pins, int *a_pins, int *value) {
    uint8_t mux_channel[16][4] = {
        {0, 0, 0, 0},  // 0
        {1, 0, 0, 0},  // 1
        {0, 1, 0, 0},  // 2
        {1, 1, 0, 0},  // 3
        {0, 0, 1, 0},  // 4
        {1, 0, 1, 0},  // 5
        {0, 1, 1, 0},  // 6
        {1, 1, 1, 0},  // 7
        {0, 0, 0, 1},  // 8
        {1, 0, 0, 1},  // 9
        {0, 1, 0, 1},  // 10
        {1, 1, 0, 1},  // 11
        {0, 0, 1, 1},  // 12
        {1, 0, 1, 1},  // 13
        {0, 1, 1, 1},  // 14
        {1, 1, 1, 1}   // 15
    };

    int i, j;

    for (i = 0; i < 16; i++) {
        for (j = 0; j < 4; j++) {
            digitalWrite(set_port[j], mux_channel[i][j]);
        }
        value[i] = analogRead(a_pins[0]);
    }
    for (i = 16; i < 30; i++) {
        for (j = 0; j < 4; j++) {
            digitalWrite(set_port[j + 4], mux_channel[i - 16][j]);
        }
        value[i] = analogRead(a_pins[1]);
    }
}

void get_rad(int data[], int threshold, float *angle, float *distance) {
    //座標の指定
    double x[30];
    double y[30];

    int i;
    int s = 0;
    int count1, count2;
    int lightcount = 0;
    int state[30];

    // x[0]y[0]（各センサの座標をとる）
    // x[0]y[0] を PT1 に対応させている。

    // 2022-12-06:基準となるx軸を原点とPT1のセンサがなす直線にした。
    for (i = 0; i < 30; i++) {
        x[i] = 47 * cos(degree_to_rad(12 * i));
        y[i] = 47 * sin(degree_to_rad(12 * i));
    }

    //しきい値を満たすセンサの取得
    for (i = 0; i < 30; i++) {
        if (data[i] > threshold) {
            state[i] = 1;
            lightcount++;
        } else {
            state[i] = 0;
        }
        // Serial.print(lightcount);
        // Serial.print(',');
        // Serial.println(state[i]);
    }

    for (i = 0; i < 30; i++) {
        if (state[i] == 1) {
            // Serial.print(i);
            s = i + 1;
            if (state[s] == 1) {
                // Serial.print(s);
                count1 = s;
            } else {
                count1 = i;
            }

            break;
        }
    }

    for (i = s + 1; i < 30; i++) {
        if (state[i] == 1) {
            // Serial.print(i);
            s = i + 1;
            if (state[s] == 1) {
                // Serial.print(s);
                count2 = s;
            } else {
                count2 = i;
            }
            break;
        }
    }

    // y = ax + b -> a -1 b
    // y = -1/a * x   tan(theta) = -1/a c = -1/a
    // theta = arctan(c);
    double a, b, c;
    a = (y[count1] - y[count2]) / (x[count1] - x[count2]);
    b = y[count1] - a * x[count1];
    c = (-1) / a;

    *distance = (fabs(b) / sqrt(a * a + 1));
    *angle = atan(c);
}

double degree_to_rad(int degree) {
    double rad;

    rad = degree * (PI / 180);
    return rad;
}

//脱出判定のプログラム
//distanceが減少して、0近くになると180度反転させる

void exit_judge(float *angle, float *distance) {
    float old_distance = *distance;
    float current_distance = *distance;
    //bool going_to_out = 0;

    if(old_distance > current_distance){
        if( 0 <= current_distance && current_distance <= 0.2 ){
            *angle = *angle - 180;
        }
        //going_to_out = 1;
    } else {
        //going_to_out = 0;
    }
}

/*
n PT
PIN0
  0 1
  1 2
  2 3
  中略
  14 15
  15 16
PIN1
  16 17
  17 18
  18 19
  19 20
  20 21
　中略
  29 30
 */
