hirame-tech/RCJ2023/(commit log)

2022-04-23 create BLDC driver board(veta)
    [untitled.brd, untitled.sch]
2022-04-23 making encorder board
    [encorder.sch, untitled.sch]
2022-04-23 made encorder board
    [Dimentions.dxf, encorder.brd, encorder.sch]
2022-04-24 making line sensor
    [untitled.brd, untitled.sch]
2022-04-24 making linesonsor_2
    [untitled.brd, untitled.sch]
2022-04-24 add monitor_speed to main
    [untitled.brd]
2022-04-24 making linesensor_3
    [untitled.brd, untitled.sch]
2022-04-25 プルのテスト
2022-04-25 put resister
    [untitled.brd, untitled.sch]
2022-04-25 Making linesensor
    [dimention.dxf, untitled.brd, untitled.sch]
2022-04-26 update linesensor
    [untitled.brd, untitled.sch]
2022-05-12 encorder & linesensor
    [dimention.dxf, encorder.brd, untitled.brd, untitled.sch]
2022-06-12 renewal ir sensor board
    [dimension.dxf, untitled.brd]
2022-06-21 update 6/22
    [untitled.brd, untitled.sch]
2022-06-21 update encorder board
    [encorder.brd, encorder.sch]
2022-06-26 add pin settings
2022-06-30 set dimention
    [dimention_driver.dxf]
2022-07-01 update 7/2
    [untitled.brd, untitled.sch]
2022-07-07 update powerboard
    [untitled.brd, untitled.sch]
2022-07-07 add IR sensor
    [untitled.brd]
2022-07-07 add dimention
    [dimention.dxf]
2022-07-09 update power board
    [untitled.sch]
2022-07-14 update boards 2022-07-14
    [untitled.brd, untitled.sch]
2022-07-15 update 2022-07-15
    [untitled.brd]
2022-07-16 コメント追加
2022-08-18 RP2040に対応
2022-09-19 add mainboard
    [untitled.sch]
2022-09-21 add brd
    [untitled.brd, untitled.sch]
2022-09-21 add dimention file
    [dimention.dxf]
2022-09-22 add power_board v2
    [untitled.brd, untitled.sch]
2022-09-23 update powerboard v2
    [5v_unit.brd, 5v_unit.sch, untitled.brd, untitled.sch]
2022-09-25 update 2022-09-25
    [5v_unit.sch]
2022-09-25 create encorder folder & move files
    [Dimentions.dxf, encorder.brd, encorder.sch]
2022-09-25 create BLDC driver v1.0 folder & move files
    [dimention_driver.dxf, untitled.brd, untitled.sch]
2022-09-25 create BLDC v1.1
    [dimention_driver.dxf, untitled.brd, untitled.sch]
2022-09-29 add gyrosensor
2022-09-29 update gyrosensor
    [untitled.brd, untitled.sch]
2022-10-03 update motordriver
    [untitled.brd, untitled.sch]
2022-10-03 配線をした
2022-10-05 provisional completion
    [5v_unit.sch, diem.dxf, untitled.brd, untitled.sch]
2022-10-11 add linesensor part
    [untitled.sch]
2022-10-18 change dimention & check DRC
    [5v_unit.brd, dimention.dxf, untitled.brd]
2022-10-18 とりあえず回路図の完成
    [untitled.sch]
2022-10-18 add IR connector
    [untitled.sch]
2022-10-18 コメントの修正
2022-10-20 add ui board
    [untitled.brd, untitled.sch]
2022-10-20 add catch sensor
    [untitled.brd, untitled.sch]
2022-10-22 add 透過センサー
    [通過_IC.brd, 通過_IC.sch]
2022-10-23 issure治ってなかった
2022-10-23 usbハブ基板完成
    [untitled.brd, untitled.sch]
2022-10-29 add solenoid board
    [untitled.brd, untitled.sch]
2022-11-01 complete wiring
    [untitled.brd, untitled.sch]
2022-11-03 complete UI board
    [dimention.dxf, untitled.sch]
2022-11-03 作業PCの変更
    [dimention.dxf, untitled.brd, untitled.sch]
2022-11-03 complete mainboard
    [untitled.brd, untitled.sch]
2022-11-03 add switch connector
    [untitled.sch]
2022-11-03 矩形波関数化
2022-11-03 add print error
2022-11-04 始動シーケンス①の追加
2022-11-04 正弦波駆動関数の実装
2022-11-04 初期リセットの追加
2022-11-05 正弦波オープンループ実装
2022-11-05 デュアルコア化
2022-11-05 矩形波クローズドループ実装完了
2022-11-05 正転ができない
2022-11-05 可変抵抗から速度を送信
2022-11-08 エラー解消
    [untitled.brd]
2022-11-08 エラーの解消
    [5v_unit.brd]
2022-11-08 可変抵抗の追加
    [untitled.brd, untitled.sch]
2022-11-08 complete gyro unit
    [dimention.dxf, untitled.brd]
2022-11-08 外形の調整
    [untitled.brd, untitled.sch]
2022-11-08 場所の調整
2022-11-09 complete BLDCdiriver
    [untitled.brd, untitled.sch]
2022-11-09 電源基板の修正
    [untitled.brd, untitled.sch]
2022-11-09 不要なファイルの削除
2022-11-10 全方位対応
2022-11-17 ある程度のひな形の追加
2022-11-18 メモ追加
2022-11-22 微妙な修正
    [5v_unit.brd, untitled.brd]
2022-11-22 なんか生成されたファイル
2022-11-22 データが飛んでこなかったときに前回の値を返すようにした
2022-11-22 リセットタイミングの追加
2022-11-22 gyroのserialの追加
2022-11-22 矩形波オープンループ動作完成
2022-11-23 些細な変更
2022-11-23 正転・逆転・速度調整実装
2022-11-23 offset設定項目の追加
2022-11-23 Revert "Merge remote-tracking branch 'origin/Develop' into feature_#37"
    This reverts commit cb103155361e8766478c6830db153463370c0739, reversing
    changes made to 84e093fe944e1f8653a6822ff34e6f8740617cb5.
    [5v_unit.brd, dimention.dxf, untitled.brd, untitled.sch]
2022-11-23 marge前のファイル
    [5v_unit.brd, dimention.dxf, untitled.brd, untitled.sch]
2022-11-24 feature37変更分
2022-11-24 Serial通信の取り決めの追加
2022-11-24 gyro周りのled処理の追加
2022-11-24 motor処理関数をクラス化した
2022-11-26 コメントを追加
2022-11-26 黄色のマスク処理の修正
2022-11-26 一部処理変更
2022-11-27 黄色の図形描画
2022-11-28 最大値設定の追加
2022-12-01 ボール追尾プログラムの追加
2022-12-07 dcモーター対応
2022-12-07 ボール追尾動作確認
2022-12-08 コメント・ラインセンサ計算処理の追加
2022-12-08 反応センサ一個の時の動作完了
2022-12-09 ラインセンサ検出アルゴリズムの変更
2022-12-09 ライン処理実装
2022-12-10 ラベリングバグ修正
2022-12-10 ラインモニタ用出力の追加
2022-12-10 ロック処理の追加
2022-12-10 跳ね返りバグ修正
2022-12-10 とりあえず動いたatノード終わり
